RBEGamer/ArduinoRGBTable/PICTURES/2024-06-10 22.00.10.jpg

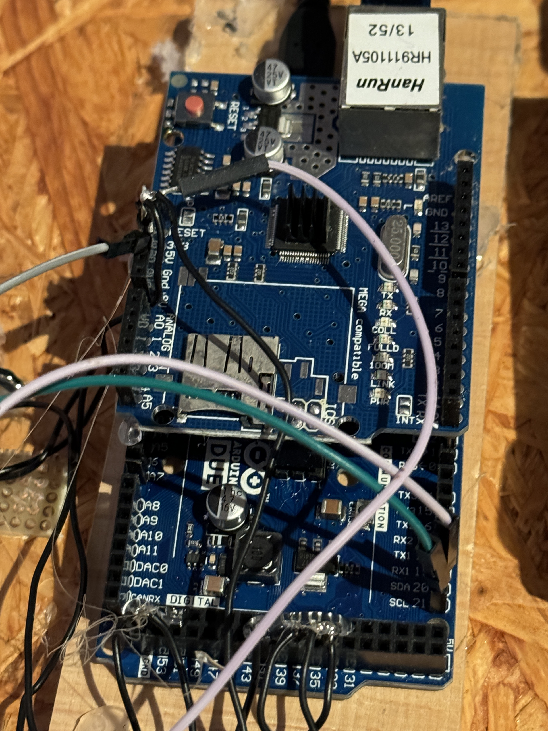
PICTURES/2024-06-10 22.00.10.jpg
