RBEGamer/ArduinoRGBTable/PICTURES/2024-06-10 22.13.32.jpg

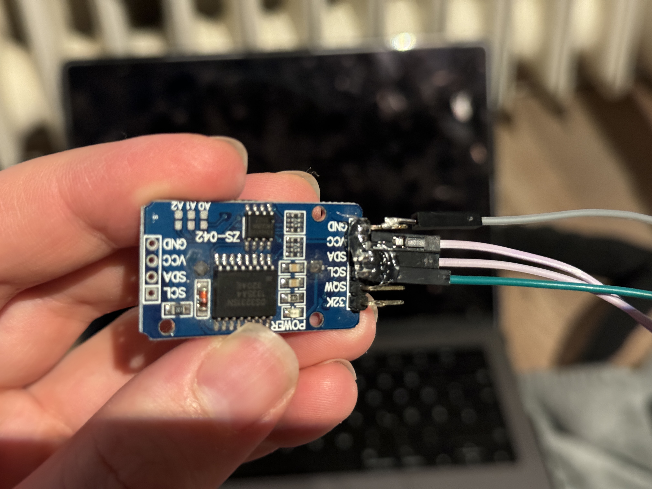
PICTURES/2024-06-10 22.13.32.jpg
