RBEGamer/ArduinoRGBTable/PICTURES/Photo-13-05-14-02-29-51-0.JPG

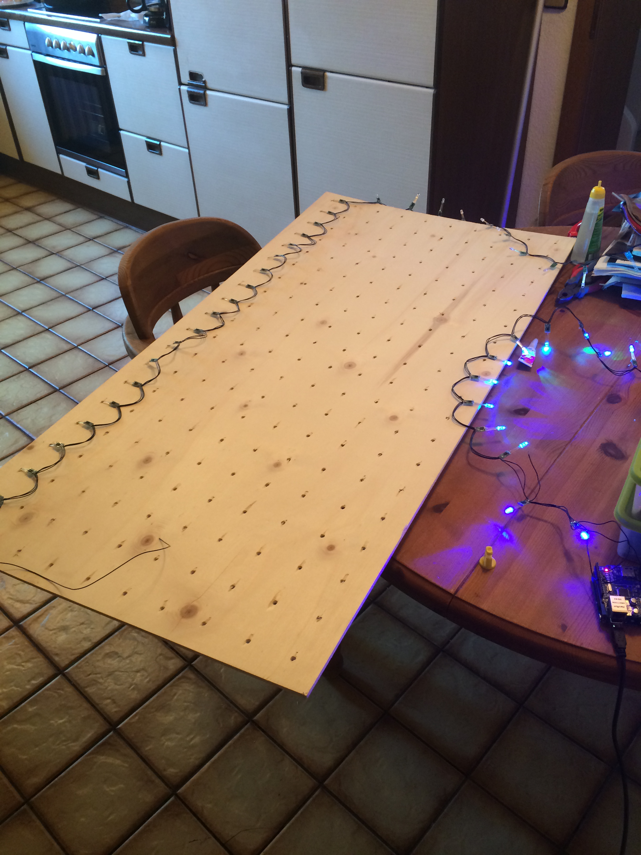
PICTURES/Photo-13-05-14-02-29-51-0.JPG
