RBEGamer/ArduinoRGBTable/PICTURES/Photo-13-05-14-02-29-52-5.JPG

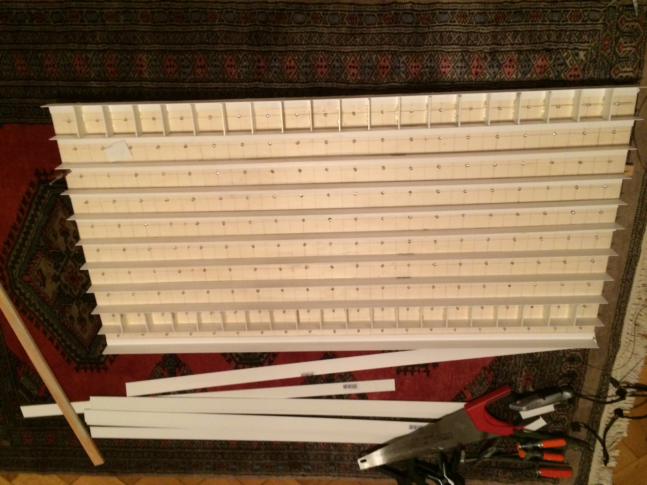
PICTURES/Photo-13-05-14-02-29-52-5.JPG
