RBEGamer/ArduinoRGBTable/PICTURES/Photo-13-05-14-02-29-52-9.JPG

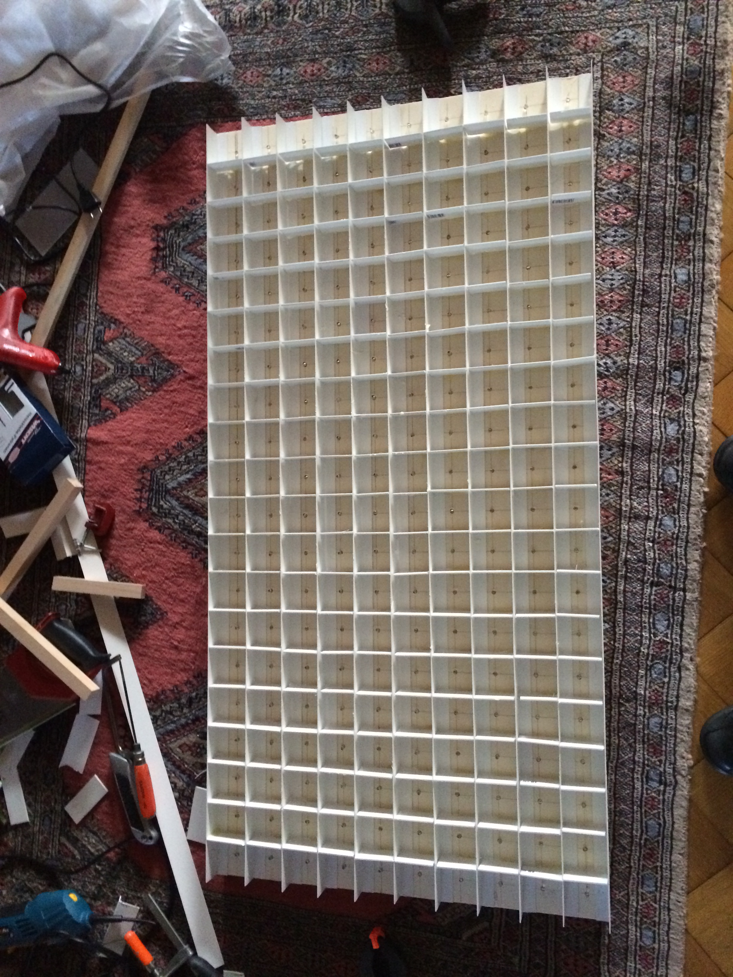
PICTURES/Photo-13-05-14-02-29-52-9.JPG
