RBEGamer/ArduinoRGBTable/PICTURES/Photo-13-05-14-02-29-53-15.JPG

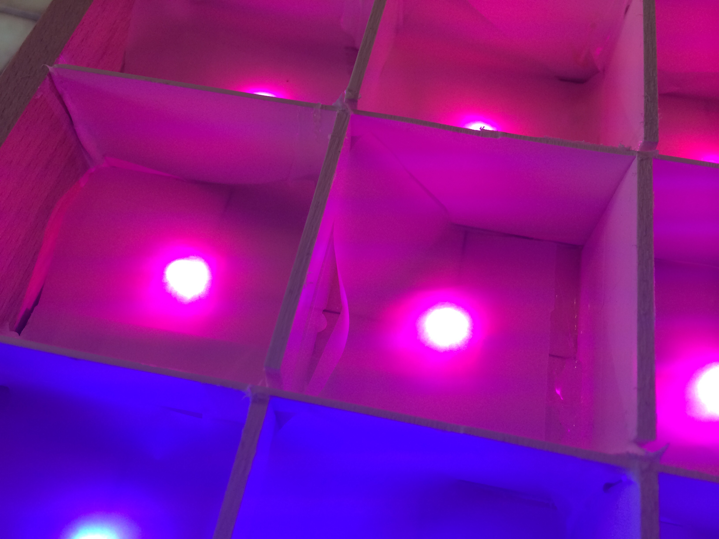
PICTURES/Photo-13-05-14-02-29-53-15.JPG
