RBEGamer/ArduinoRGBTable/PICTURES/Photo-13-05-14-02-29-53-21.JPG

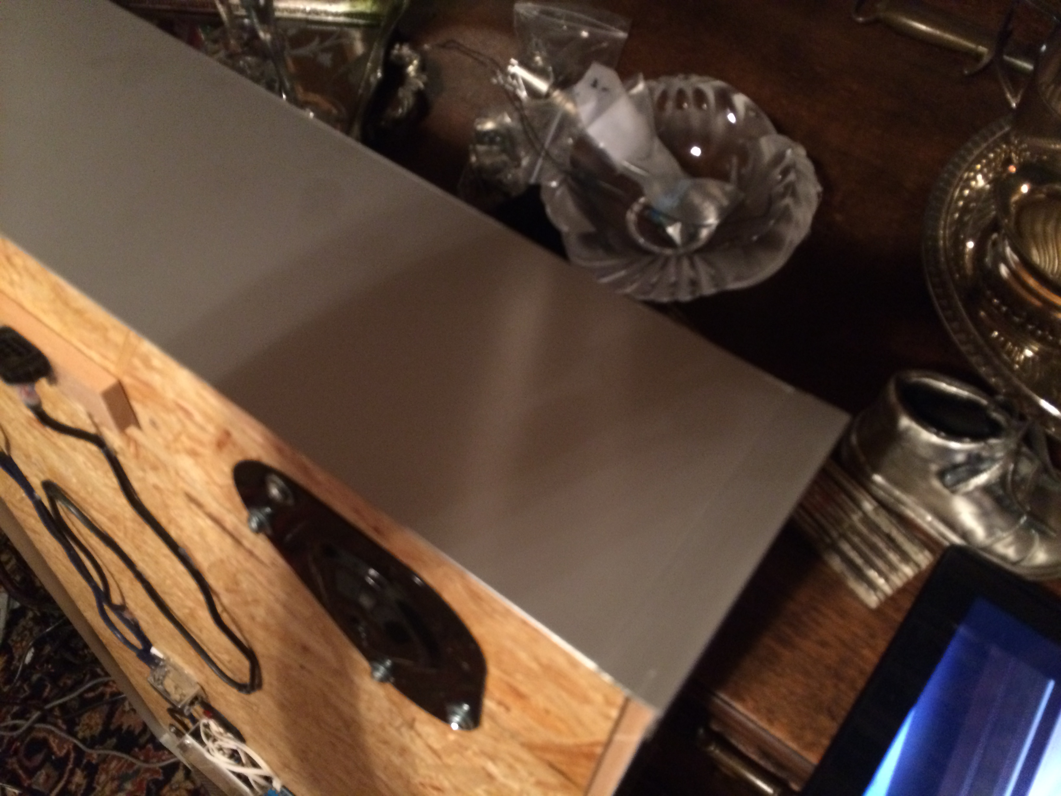
PICTURES/Photo-13-05-14-02-29-53-21.JPG
