RBEGamer/ArduinoRGBTable/PICTURES/Photo-13-05-14-02-29-53-23.JPG

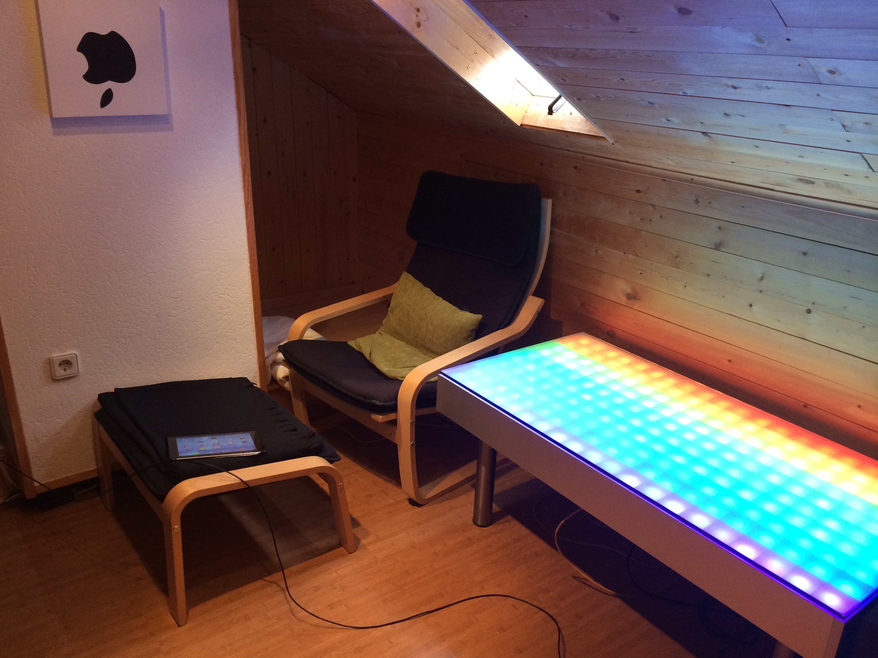
PICTURES/Photo-13-05-14-02-29-53-23.JPG
