RBEGamer/ArduinoRGBTable/PICTURES/Photo-13-05-14-02-29-54-25.JPG

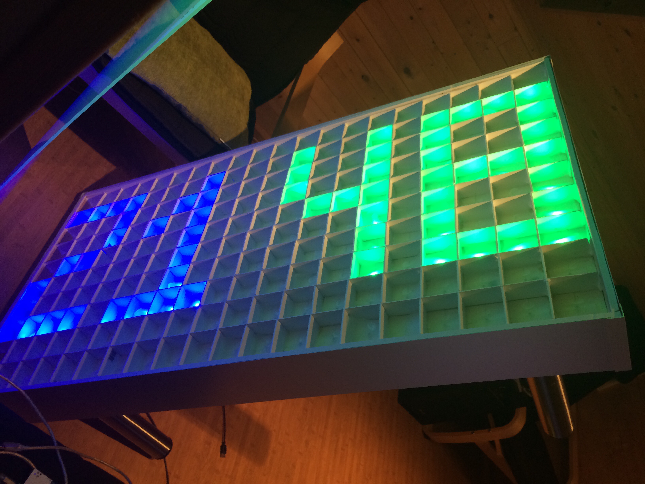
PICTURES/Photo-13-05-14-02-29-54-25.JPG
