RBEGamer/ArduinoRGBTable/src/table_due_beta35/table_due_beta35_Websitetitel.ino

#include <Adafruit_NeoPixel.h>
#include "SPI.h"
#include "Ethernet.h"
#include "WebServer.h"
#include "Wire.h"
#include <DueFlashStorage.h>
#include <TextFinder.h>

//PIN CONFIG
#define WS2812_PIN 33
#define WS2812_STANDBY_LED_PIN 31
const int relais = 35; //relais pin to enable the led power
const int fan = 37; //relais pin to enable the relais for the fan
const int pi_en = 39; // pin to send enabel for the T.I.S (RPI needed)
const int reset_jumper = 41; // pin for the standby switch

DueFlashStorage dueFlashStorage;
static uint8_t mac[6] = { 0x00, 0x00, 0x00, 0x00, 0x00, 0x23 };
Adafruit_NeoPixel standby_strip = Adafruit_NeoPixel(1, WS2812_STANDBY_LED_PIN, NEO_RGB + NEO_KHZ800);
Adafruit_NeoPixel strip = Adafruit_NeoPixel(200, WS2812_PIN, NEO_RGB + NEO_KHZ800);


const String versionsnummer = "Beta 1.5.5";
String webTitle = "RBE LED-Table";

int nullpunkt = 0; //0: oben links, 1: oben rechts, 2: unten links, 3: unten rechts
int Ausrichtung = 0; //0: Ausrichtung nach Reihe; 1: Ausrichtung nach Spalte
int invertNES = 0; //0 = nicht invertieren, 1 gleich invertieren
const int webui_port = 80;

//FÜR SERVER << "";
template<class T>
inline Print &operator <<(Print &obj, T arg)
{
  obj.print(arg);
  return obj;
}
#define PREFIX "" //WEBSERVER ROOT URL (http://ip/xxx
WebServer webserver(PREFIX, webui_port);
const unsigned int feldx = 20;
const unsigned int feldy = 10;

const int baud_rate = 115200;

int fillred = 0;            //integer for red darkness
int fillblue = 0;           //integer for blue darkness
int fillgreen = 0;          //integer for green darkness
int fan_state = 0;
int mode = 5; // MODE 5 = off
int rainbowspeed = 50;
int randomspeed = 10;
int randommode = 0; // 0-1
int rainbowmode = 0; // 0 oder 1
int randomefmode = 0;
int standby_strip_state = 0; //FÜR DIE STANDBYLED
int standby_strip_fade = 0;
int standby_strip_fade_richtung = 0; // 0 = plus, 1 = minus
IPAddress ip(192, 168, 178, 210);
IPAddress gateway(192, 168, 178, 1);
IPAddress subnet(255, 255, 255, 0);
const int use_ethernet = 1, wait_for_DHCP = 0;
int enable_dhcp = 1;
int api_enable = 1;
int standby_strip_en = 1;
const int webTitle_max_char = 40;
//CLOCK VARS---------------------------------------------------------------------------------------------------
#define DS1307_I2C_ADDRESS 0x68  // This is the I2C address
// Arduino version compatibility Pre-Compiler Directives
#if defined(ARDUINO) && ARDUINO >= 100   // Arduino v1.0 and newer
#define I2C_WRITE Wire.write
#define I2C_READ Wire.read
#else                                   // Arduino Prior to v1.0 
#define I2C_WRITE Wire.send
#define I2C_READ Wire.receive
#endif
long previousMillis = 0;        // will store last time Temp was updated
byte second, minute, hour, dayOfWeek, dayOfMonth, month, year;
byte test;
byte zero;
// Convert normal decimal numbers to binary coded decimal
byte decToBcd(byte val) {
  return ( (val / 10 * 16) + (val % 10) );
}
// Convert binary coded decimal to normal decimal numbers
byte bcdToDec(byte val) {
  return ( (val / 16 * 10) + (val % 16) );
}
int clockcolormode = 0;
int clock_h_color;
int clock_m_color;
int clock_fix_color_h = 0;
int clock_fix_color_m = 0;
int clock_bright = 255;
int h_z = 0;
int h_e = 0;
byte binwert_h_z;
byte binwert_h_e;
int m_z = 0;
int m_e = 0;
byte binwert_m_z;
byte binwert_m_e;
unsigned int localPort = 8888;      // local port to listen for UDP packets
IPAddress timeServer(132, 163, 4, 103);
const int NTP_PACKET_SIZE = 48; // NTP time stamp is in the first 48 bytes of the message
byte packetBuffer[ NTP_PACKET_SIZE]; //buffer to hold incoming and outgoing packets
EthernetUDP Udp;
int ntph = 0;
int ntpm = 0;
int ntps = 0;
unsigned int zeitverschiebung = 2; //zeit um 2 stunden nach vorne verschieben
int clock_color_counter = 0;
int clock_color_speed = 50;
int nth = 22;
int nthe = 7;
int nthen = 1;
int nthstate = 0;
int nthonmode = 1;
int nthoffmode = 6;
int number_template_0[4][7];
int number_template_1[4][7];
int number_template_2[4][7];
int number_template_3[4][7];
int number_template_4[4][7];
int number_template_5[4][7];
int number_template_6[4][7];
int number_template_7[4][7];
int number_template_8[4][7];
int number_template_9[4][7];
int number_template_nothing[4][7];

int time1[4][7]; // 0 oder 1 (0 = nicht gesetzt)
int time2[4][7];
int time3[4][7];
int time4[4][7];
int time1_anchor[2] = {16, 2}; // HZ
int time2_anchor[2] = {11, 2}; //HE
int time3_anchor[2] = {5, 2}; // MZ
int time4_anchor[2] = {0, 2}; // ME
int template_buffer_array[4][7];
int tmp_hz, tmp_he, tmp_mz, tmp_me;
int x = 0, y = 0;
int _value;
//CLOCK VARS ENDE

//-----------------------------------------------------für bootscreeen + animation-------------------------------------------------------------------------------
int table_os_enable = 1;
//---------------------------------------------------------------------------------------------------------------------------------------------------------------------------------

//LAUFSCHRIFT VARS  ----------------------------------------------------------------------------------
const int st_prev_begin = 21; //versatz zum ersten buchstaben damit pixelfehler am anfang nicht auffahlen
const int st_after_end = feldx;//muss einmal die feldbreite sein damit auch die ersten buchstaben eingeflogen kommen und nicht schon am anfang da stehen
int st_text_pos = 0;
const int st_maxchar = 255;
char st_chars[st_maxchar] = {'h', 'e', 'l', 'l', 'o'};
int st_char_count = 5;
int st_speed = 70;
const int st_spacing = 2;
int st_laufschrift_complete_arr[((5 + st_spacing)*st_maxchar) + st_after_end + st_prev_begin][7];
int st_anchor[2] = {0, 0};
int st_char_count_saved = 0;
int st_chars_saved[st_maxchar];
int st_fix_color = 0;
int st_rain_speed = 5;
int st_color_mode = 0;
int st_bright = 255;
int st_color = 0;
int st_color_counter = 0;

//TIS VARS ---+ die st_ vars-------------------------------------------------------------------------------
int rss_enable = 1;
int rss_state = 0;
int rss_prev_mode = 3;
const int rss_mode = 9;
char rss_chars[st_maxchar];
int rss_text_count = 0;
int rss_max_loops = 3;
int rss_current_loops = 0;
int rss_can_break_during_game = 1;
int rss_recive_count = 0;
String rss_revive_cmd = "";

int char_template[5][7];
int char_template_a[5][7];
int char_template_b[5][7];
int char_template_c[5][7];
int char_template_d[5][7];
int char_template_e[5][7];
int char_template_f[5][7];
int char_template_g[5][7];
int char_template_h[5][7];
int char_template_i[5][7];
int char_template_j[5][7];
int char_template_k[5][7];
int char_template_l[5][7];
int char_template_m[5][7];
int char_template_n[5][7];
int char_template_o[5][7];
int char_template_p[5][7];
int char_template_q[5][7];
int char_template_r[5][7];
int char_template_s[5][7];
int char_template_t[5][7];
int char_template_u[5][7];
int char_template_v[5][7];
int char_template_w[5][7];
int char_template_x[5][7];
int char_template_y[5][7];
int char_template_z[5][7];
int char_template_sz[5][7];
int char_template_1[5][7];
int char_template_2[5][7];
int char_template_3[5][7];
int char_template_4[5][7];
int char_template_5[5][7];
int char_template_6[5][7];
int char_template_7[5][7];
int char_template_8[5][7];
int char_template_9[5][7];
int char_template_0[5][7];
int char_template_nothing[5][7];
int char_template_sharp[5][7];
int char_template_dot[5][7];
int char_template_comma[5][7];
int char_template_bracketopen[5][7];
int char_template_bracketclose[5][7];
int char_template_equal[5][7];
int char_template_plus[5][7];
int char_template_minus[5][7];
int char_template_bang[5][7];
int char_template_doubledot[5][7];
int char_template_underline[5][7];
int char_template_quest[5][7];
int char_template_percent[5][7];
int char_template_high[5][7];
int char_template_simikolon[5][7];
int char_template_smaller[5][7];
int char_template_bigger[5][7];
int char_template_hline[5][7];
int char_template_star[5][7];
int char_template_at[5][7];
//ENDE LAUFSCHRIFT VARS ----------------------------------------------------------------------------------

//PAINT VARS--------------------------------
int paint_boot_strip[70];
int paint_boot_wheelpos = 0;
int paint_wheel_pos = 0;
int paint_pointer[2] = {feldx / 2, feldy / 2};
int paint_ponter_color[3] = {255, 255, 255};
int paint_grid[feldx][feldy][3];
int paint_color_display_mode = 0;
int paint_background[3] = {0, 0, 0};

//SQUARE VARS---------------------------------
const int square_number_field_offset[2] = {5, 0};
int square_number_field[5][5][2]; // 0 = wert // 1 = moved
int square_new_number_pos[2];
int square_start_numbers[2] = {2, 4};
int square_new_number = 0;
int square_cycle_value = 0;
int square_active_fields = 0;
int square_allow_reset = 1;
int square_animation_speed = 10;
byte square_p1_controller_data_tmp = 0;
unsigned int square_boot_strip[48];
int square_boot_wheelpos = 0;

//SENSO VARS-------------------------
unsigned int senso_strip[44];
unsigned int senso_cross_strip[5];
unsigned int senso_cross_up;
unsigned int senso_cross_down;
unsigned int senso_cross_left;
unsigned int senso_cross_right;
unsigned int senso_select_strip[2];
unsigned int senso_start_strip[2];
unsigned int senso_b_strip[4];
unsigned int senso_a_strip[4];
int senso_show_buttons = 1;
int senso_include_startselect = 0;
const int senso_max_length = 100;
byte senso_p1_controller_data_tmp = 0;
int senso_order[senso_max_length] = {0};
int senso_length = 1;
int senso_p1_pos = 0;
int senso_player_wrong = 0; //0: beide richtig, 1: p1 falsch, 2: p2 falsch, 3:beide falsch
int senso_wheelpos = 1;
int senso_button_color_r = 255, senso_button_color_g = 255, senso_button_color_b = 0;
int senso_button_order_r = 0, senso_button_order_g = 0, senso_button_order_b = 255;
int senso_last_button_red = 0;
int senso_show_delay = 500;

//PONG VARS ----------------------------------------------------------------------------------
unsigned int pong_boot_strip[66];
int pong_boot_wheelpos = 0;
int ballx = feldx / 2;
int bally = feldy / 2;
int balldir = 4; //random
int player1score = 0;
int player2score = 0;
int paddle1x = 0;
int paddle2x = feldx - 1;
int paddle1y = 0;
int paddle2y = 0;
int paddle1size = 3;
int paddle2size = 3;
int tmp_paddle1y = 0;
int tmp_paddle2y = 0;
const int action_timer = 3; //WIE VIELE KONTROLLERABFRAGEN PRO BALLBEWEGUNG
int unsigned pong_game_speed = 50; //ANFANGSSPEED
const unsigned int min_game_speed = 10; //MINIMUM SPEED
int tmp_speed = 0; //HIER IST IMME DER AKTUELLE SPPED DRINNE
const int score_delay = 3000;
int player1score_tmp = 0; //FÜR DIE SPEED BERECHNUNG
int player2score_tmp = 0;
int ball_r = 0, ball_g = 0, ball_b = 255;
int p1_r = 0, p1_g = 255, p1_b = 0;
int p2_r = 255, p2_g = 0, p2_b = 0;
int p1_latch = A1; // set the latch pin
int p1_clock = A0; // set the clock pin
int p1_datin = A2;// set the data in pin
int p2_latch = A4;// set the latch pin
int p2_clock = A3; // set the clock pin
int p2_datin = A5;// set the data in pin
byte p1_controller_data = 0;
byte p2_controller_data = 0;
int counter = 0;//WIE VIELE KONTROLLERABFRAGEN haben bereits stattgefunden PRO BALLBEWEGUNG
const int max_score = feldy; //MAXIMALE MPUNKTE MUSS KLEINER ALS Y PIXELANZAHL
int last_looser = 0; //WER HAT ZULETZT VERLOREN FÜR DIE FARBEN BEIM SCORESCREEN
int color_state = 0; // 0-> nach rot 1-> nach grün 2-> nach blau
int tmp_green = 0;
int tmp_red = 0;
int tmp_blue = 0;
int fade_speed = 5;
int pongmode = 1;
int chenp1 = 0;
int chenp2 = 0;
int pongenreset = 0;
// ENDE PONG VARS -------------------------------

void set_arrays() { //muss immer ausgeführt werden wenn der nullpunkt geändert wurde
  //table os bootscreen



  //----------------------------------
  //square bootscreen
  square_boot_strip = { get_led_number(0, 7), get_led_number(0, 4), get_led_number(1, 7), get_led_number(1, 5), get_led_number(1, 3), get_led_number(2, 6), get_led_number(2, 3), get_led_number(4, 6), get_led_number(4, 5), get_led_number(4, 4), get_led_number(5, 7), get_led_number(5, 3), get_led_number(6, 7), get_led_number(6, 6), get_led_number(6, 3), get_led_number(7, 6), get_led_number(7, 5), get_led_number(7, 4), get_led_number(9, 7), get_led_number(9, 6), get_led_number(9, 5), get_led_number(9, 4), get_led_number(10, 5), get_led_number(10, 3), get_led_number(11, 5), get_led_number(11, 3), get_led_number(12, 7), get_led_number(12, 6), get_led_number(12, 5), get_led_number(12, 4), get_led_number(14, 7), get_led_number(14, 6), get_led_number(14, 5), get_led_number(14, 4), get_led_number(14, 3), get_led_number(15, 5), get_led_number(15, 3), get_led_number(16, 7), get_led_number(16, 6), get_led_number(16, 4), get_led_number(18, 7), get_led_number(18, 6), get_led_number(18, 5), get_led_number(18, 4), get_led_number(18, 3), get_led_number(19, 7), get_led_number(19, 5), get_led_number(19, 3)};
  //--------------------------------
  //senso
  senso_strip = { get_led_number(0, 4), get_led_number(0, 7), get_led_number(1, 3), get_led_number(1, 5), get_led_number(1, 7), get_led_number(2, 3), get_led_number(2, 6), get_led_number(4, 3), get_led_number(4, 4), get_led_number(4, 5), get_led_number(4, 6), get_led_number(4, 7), get_led_number(5, 3), get_led_number(5, 5), get_led_number(5, 7), get_led_number(7, 3), get_led_number(7, 4), get_led_number(7, 5), get_led_number(7, 6), get_led_number(7, 7), get_led_number(8, 4), get_led_number(9, 5), get_led_number(10, 3), get_led_number(10, 4), get_led_number(10, 5), get_led_number(10, 6), get_led_number(10, 7), get_led_number(12, 4), get_led_number(12, 7), get_led_number(13, 3), get_led_number(13, 5), get_led_number(13, 7), get_led_number(14, 3), get_led_number(14, 6), get_led_number(16, 4), get_led_number(16, 5), get_led_number(16, 6), get_led_number(17, 3), get_led_number(17, 7), get_led_number(18, 3), get_led_number(18, 7), get_led_number(19, 4), get_led_number(19, 5), get_led_number(19, 6)};
  senso_cross_strip = { get_led_number(1, 5), get_led_number(2, 4), get_led_number(2, 5), get_led_number(2, 6), get_led_number(3, 5)};
  senso_cross_up = get_led_number(2, 4);
  senso_cross_down = get_led_number(2, 6);
  senso_cross_left = get_led_number(1, 5);
  senso_cross_right = get_led_number(3, 5);
  senso_select_strip = {get_led_number(6, 5), get_led_number(7, 5)};
  senso_start_strip = {get_led_number(10, 5), get_led_number(11, 5) };
  senso_b_strip = {get_led_number(14, 4), get_led_number(14, 5), get_led_number(15, 4), get_led_number(15, 5)};
  senso_a_strip = {get_led_number(17, 4), get_led_number(17, 5), get_led_number(18, 4), get_led_number(18, 5)};
  //------------------------------------------
  //pong
  pong_boot_strip = {get_led_number(0, 1), get_led_number(0, 2), get_led_number(0, 3), get_led_number(0, 4), get_led_number(0, 5), get_led_number(0, 6), get_led_number(0, 7), get_led_number(0, 8), get_led_number(1, 1), get_led_number(1, 4), get_led_number(2, 1), get_led_number(2, 4), get_led_number(3, 2), get_led_number(3, 3), get_led_number(5, 2), get_led_number(5, 3), get_led_number(5, 4), get_led_number(5, 5), get_led_number(5, 6), get_led_number(5, 7), get_led_number(6, 1), get_led_number(6, 8), get_led_number(7, 1), get_led_number(7, 8), get_led_number(8, 2), get_led_number(8, 3), get_led_number(8, 4), get_led_number(8, 5), get_led_number(8, 6), get_led_number(8, 7), get_led_number(10, 1), get_led_number(10, 2), get_led_number(10, 3), get_led_number(10, 4), get_led_number(10, 5), get_led_number(10, 6), get_led_number(10, 7), get_led_number(10, 8), get_led_number(11, 1), get_led_number(11, 2), get_led_number(12, 3), get_led_number(12, 4), get_led_number(13, 5), get_led_number(13, 6), get_led_number(14, 1), get_led_number(14, 2), get_led_number(14, 3), get_led_number(14, 4), get_led_number(14, 5), get_led_number(14, 6), get_led_number(14, 7), get_led_number(14, 8), get_led_number(16, 2), get_led_number(16, 3), get_led_number(16, 4), get_led_number(16, 5), get_led_number(16, 6), get_led_number(16, 7), get_led_number(17, 1), get_led_number(17, 8), get_led_number(18, 1), get_led_number(18, 5), get_led_number(18, 8), get_led_number(19, 2), get_led_number(19, 6), get_led_number(19, 7) };
  //---------------------------------------------
  //paint
  paint_boot_strip = {get_led_number(0, 1), get_led_number(0, 2), get_led_number(0, 3), get_led_number(0, 4), get_led_number(0, 5), get_led_number(0, 6), get_led_number(0, 7), get_led_number(0, 8), get_led_number(1, 1), get_led_number(1, 4), get_led_number(2, 1), get_led_number(2, 4), get_led_number(3, 2), get_led_number(3, 3),  get_led_number(5, 2), get_led_number(5, 3), get_led_number(5, 4), get_led_number(5, 5), get_led_number(5, 6), get_led_number(5, 7), get_led_number(5, 8), get_led_number(6, 1), get_led_number(6, 4), get_led_number(7, 2), get_led_number(7, 3), get_led_number(7, 4), get_led_number(7, 5), get_led_number(7, 6), get_led_number(7, 7), get_led_number(7, 8), get_led_number(9, 1), get_led_number(9, 2), get_led_number(9, 3), get_led_number(9, 4), get_led_number(9, 5), get_led_number(9, 6), get_led_number(9, 7), get_led_number(9, 8), get_led_number(11, 1), get_led_number(11, 2), get_led_number(11, 3), get_led_number(11, 4), get_led_number(11, 5), get_led_number(11, 6), get_led_number(11, 7), get_led_number(11, 8), get_led_number(12, 1), get_led_number(12, 2), get_led_number(13, 3), get_led_number(13, 4), get_led_number(14, 5), get_led_number(14, 6), get_led_number(15, 1), get_led_number(15, 2), get_led_number(15, 3), get_led_number(15, 4), get_led_number(15, 5), get_led_number(15, 6), get_led_number(15, 7), get_led_number(15, 8), get_led_number(17, 1), get_led_number(18, 1), get_led_number(18, 2), get_led_number(18, 3), get_led_number(18, 4), get_led_number(18, 5), get_led_number(18, 6), get_led_number(18, 7), get_led_number(18, 8), get_led_number(19, 1)};
  //-----------------------------------------------
}

void st_text_to_arr() {
  for (int i = 0; i < ((5 + st_spacing)*st_maxchar) + st_after_end + st_prev_begin; i++) {
    for (int j = 0; j < 7; j++) {
      st_laufschrift_complete_arr[i][j] = 0;
    }
  }
  for (int k = 0; k < st_char_count; k++) {
    if (st_chars[k] == 'a' || st_chars[k] == 'A') {
      for (int i = 0; i < 5; i++) {
        for (int j = 0; j < 7; j++) {
          char_template[i][j] = char_template_a[i][j];
        }
      }
    }
    if (st_chars[k] == 'b' || st_chars[k] == 'B') {
      for (int i = 0; i < 5; i++) {
        for (int j = 0; j < 7; j++) {
          char_template[i][j] = char_template_b[i][j];
        }
      }
    }
    if (st_chars[k] == 'c' || st_chars[k] == 'C') {
      for (int i = 0; i < 5; i++) {
        for (int j = 0; j < 7; j++) {
          char_template[i][j] = char_template_c[i][j];
        }
      }
    }
    if (st_chars[k] == 'd' || st_chars[k] == 'D') {
      for (int i = 0; i < 5; i++) {
        for (int j = 0; j < 7; j++) {
          char_template[i][j] = char_template_d[i][j];
        }
      }
    }
    if (st_chars[k] == 'e' || st_chars[k] == 'E') {
      for (int i = 0; i < 5; i++) {
        for (int j = 0; j < 7; j++) {
          char_template[i][j] = char_template_e[i][j];
        }
      }
    }
    if (st_chars[k] == 'f' || st_chars[k] == 'F') {
      for (int i = 0; i < 5; i++) {
        for (int j = 0; j < 7; j++) {
          char_template[i][j] = char_template_f[i][j];
        }
      }
    }
    if (st_chars[k] == 'g' || st_chars[k] == 'G') {
      for (int i = 0; i < 5; i++) {
        for (int j = 0; j < 7; j++) {
          char_template[i][j] = char_template_g[i][j];
        }
      }
    }
    if (st_chars[k] == 'h' || st_chars[k] == 'H') {
      for (int i = 0; i < 5; i++) {
        for (int j = 0; j < 7; j++) {
          char_template[i][j] = char_template_h[i][j];
        }
      }
    }
    if (st_chars[k] == 'i' || st_chars[k] == 'I') {
      for (int i = 0; i < 5; i++) {
        for (int j = 0; j < 7; j++) {
          char_template[i][j] = char_template_i[i][j];
        }
      }
    }
    if (st_chars[k] == 'j' || st_chars[k] == 'J') {
      for (int i = 0; i < 5; i++) {
        for (int j = 0; j < 7; j++) {
          char_template[i][j] = char_template_j[i][j];
        }
      }
    }
    if (st_chars[k] == 'k' || st_chars[k] == 'K') {
      for (int i = 0; i < 5; i++) {
        for (int j = 0; j < 7; j++) {
          char_template[i][j] = char_template_k[i][j];
        }
      }
    }
    if (st_chars[k] == 'l' || st_chars[k] == 'L') {
      for (int i = 0; i < 5; i++) {
        for (int j = 0; j < 7; j++) {
          char_template[i][j] = char_template_l[i][j];
        }
      }
    }
    if (st_chars[k] == 'm' || st_chars[k] == 'M') {
      for (int i = 0; i < 5; i++) {
        for (int j = 0; j < 7; j++) {
          char_template[i][j] = char_template_m[i][j];
        }
      }
    }
    if (st_chars[k] == 'n' || st_chars[k] == 'N') {
      for (int i = 0; i < 5; i++) {
        for (int j = 0; j < 7; j++) {
          char_template[i][j] = char_template_n[i][j];
        }
      }
    }
    if (st_chars[k] == 'o' || st_chars[k] == 'O') {
      for (int i = 0; i < 5; i++) {
        for (int j = 0; j < 7; j++) {
          char_template[i][j] = char_template_o[i][j];
        }
      }
    }
    if (st_chars[k] == 'p' || st_chars[k] == 'P') {
      for (int i = 0; i < 5; i++) {
        for (int j = 0; j < 7; j++) {
          char_template[i][j] = char_template_p[i][j];
        }
      }
    }
    if (st_chars[k] == 'q' || st_chars[k] == 'Q') {
      for (int i = 0; i < 5; i++) {
        for (int j = 0; j < 7; j++) {
          char_template[i][j] = char_template_q[i][j];
        }
      }
    }
    if (st_chars[k] == 'r' || st_chars[k] == 'R') {
      for (int i = 0; i < 5; i++) {
        for (int j = 0; j < 7; j++) {
          char_template[i][j] = char_template_r[i][j];
        }
      }
    }
    if (st_chars[k] == 's' || st_chars[k] == 'S') {
      for (int i = 0; i < 5; i++) {
        for (int j = 0; j < 7; j++) {
          char_template[i][j] = char_template_s[i][j];
        }
      }
    }
    if (st_chars[k] == 't' || st_chars[k] == 'T') {
      for (int i = 0; i < 5; i++) {
        for (int j = 0; j < 7; j++) {
          char_template[i][j] = char_template_t[i][j];
        }
      }
    }
    if (st_chars[k] == 'u' || st_chars[k] == 'U') {
      for (int i = 0; i < 5; i++) {
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
          char_template[i][j] = char_template_nothing[i][j];
        }
      }
    }
    for (int i = 0; i < 5; i++) {
      for (int j = 0; j < 7; j++) {
        st_laufschrift_complete_arr[(k * st_spacing * 3) + st_prev_begin + i][j] = char_template[i][j];
      }
    }
  }
}

void rss_convert_text() {
  st_save_text();
  clear_screen();
  strip.show();
  for (int i = 0; i < st_maxchar; i++) {
    st_chars[i] = 0;
    st_chars[i] = rss_chars[i];
  }
  st_char_count = rss_text_count;
  rss_current_loops = 0;
  rss_state = 1;
}

void rss_process() {
  if (rss_enable == 1) {
    if (rss_state == 1) {
      if (mode != rss_mode) {
        if (rss_can_break_during_game == 1) {
          mode = rss_mode;
        } else {
          if (mode  == 4) {} else {
            mode = rss_mode;
          }
          if (mode  == 10) {} else {
            mode = rss_mode;
          }
          if (mode  == 11) {} else {
            mode = rss_mode;
          }
          if (mode  == 12) {} else {
            mode = rss_mode;
          }
        }
      }
      if (rss_current_loops > rss_max_loops) {
        rss_state = 0;
        rss_current_loops = 0;
        for (int i = 0; i < st_maxchar; i++) {
          rss_chars[i] = 0;
        }
        st_restore_text();
        clear_screen();
        strip.show();
      }
    }
  }
}

void rss_recive_serial() {
  if (Serial1.available()) {
    char c = Serial1.read();
    if (c == '\n') {
      rss_recive_count = 0;
      rss_revive_cmd = "";
      rss_revive_cmd.toCharArray(rss_chars, st_maxchar);
      rss_convert_text();
      rss_state = 1;
    } else {
      rss_revive_cmd += c;
      rss_recive_count++;
    }
  }
}

void st_save_text() {
  st_char_count_saved = st_char_count;
  for (int i = 0; i < st_maxchar; i++) {
    st_chars_saved[i] = 0;
    st_chars_saved[i] = st_chars[i];
  }
}

void st_restore_text() {
  for (int i = 0; i < st_maxchar; i++) {
    st_chars[i] = 0;
    st_chars[i] = st_chars_saved[i];
  }
  st_char_count = st_char_count_saved;
}

void st_play() {
  if (st_text_pos >= ((5 + st_spacing)*st_char_count) + st_after_end + st_prev_begin) {
    st_text_pos = 0;
    rss_current_loops++;
  } else {
    st_text_pos++;
  }
  if (st_color_counter >= 256) {
    st_color_counter = 0;
  } else {
    st_color_counter += st_rain_speed;
  }
  if (st_color_mode == 0) {
    st_color =  Wheel(st_color_counter);
  } else if (st_color_mode == 1) {
    if (st_fix_color == 0) {
      st_color =  strip.Color(st_bright, 0, 0);
    } else  if (st_fix_color == 1) {
      st_color =  strip.Color(0, st_bright, 0);
    } else  if (st_fix_color == 2) {
      st_color =  strip.Color(0, 0, st_bright);
    } else  if (st_fix_color == 3) {
      st_color =  strip.Color(0, st_bright, st_bright);
    } else  if (st_fix_color == 4) {
      st_color =  strip.Color(st_bright, 0, st_bright);
    } else  if (st_fix_color == 5) {
      st_color =  strip.Color(st_bright, st_bright, 0);
    } else  if (st_fix_color == 6) {
      st_color =  strip.Color(st_bright, st_bright, st_bright);
    } else {
      st_color =  strip.Color(0, 0, 255);
    }
  } else if (st_color_mode == 2) {
  } else {
    st_color =  strip.Color(0, 0, 255);
  }
  for (int i = 0; i < 20; i++) {
    for (int j = 0; j < 7; j++) {
      if (st_color_mode == 2) {
        st_color =  Wheel(random(0, 257));
      }
      if (st_laufschrift_complete_arr[st_prev_begin + st_text_pos + i - st_after_end][j] == 1) {
        strip.setPixelColor(get_led_number(i + st_anchor[0], j + st_anchor[1] + 1),  st_color);
      } else {
        strip.setPixelColor(get_led_number(i + st_anchor[0], j + st_anchor[1] + 1),  strip.Color(0, 0, 0));
      }
    }
  }
  delay(st_speed);
}//ENDE VOID

P(phead1) =
  "<!DOCTYPE html><html><head>"
  "<title>";
  
P(phead2) =
  "</title>"
  "<meta http-equiv='content-type' content='text/html; charset=utf-8'>"
  "<meta charset='utf-8'>"
  "<link href='http://ajax.googleapis.com/ajax/libs/jqueryui/1.8.16/themes/base/jquery-ui.css' rel=stylesheet />"
  "<script src='http://ajax.googleapis.com/ajax/libs/jquery/1.6.4/jquery.min.js'></script>"
  "<script src='http://ajax.googleapis.com/ajax/libs/jqueryui/1.8.16/jquery-ui.min.js'></script>"
  "<style> body {  } #red, #green, #blue { margin: 10px; } #red { background: #f00; } #green { background: #0f0; } #blue { background: #00f; } </style>"
  "<script>"
  "function changeRGB(event, ui) { jQuery.ajaxSetup({timeout: 110}); /*not to DDoS the Arduino, you might have to change this to some threshold value that fits your setup*/ var id = $(this).attr('id'); if (id == 'red') $.post('/rgb', { red: ui.value } ); if (id == 'green') $.post('/rgb', { green: ui.value } ); if (id == 'blue') $.post('/rgb', { blue: ui.value } ); } "
  "$(document).ready(function(){ $('#red, #green, #blue').slider({min: 0, max:255, change:changeRGB, slide:changeRGB}); });"
  "</script>"
  "<style>"

  "html, body {"
  "	background: #F2F2F2;"
  "	width: 100%;"
  "	height: 100%;"
  "	margin: 0px;"
  "	padding: 0px;"
  "	font-family: 'Verdana';"
  "	font-size: 16px;"
  "	color: #404040;"
  "	}"
  "img {"
  "	border: 0px;"
  "}"
  "span.title {"
  "	display: block;"
  "	color: #000000;"
  "	font-size: 30px;"
  "}"
  "span.subtitle {"
  "	display: block;"
  "	color: #000000;"
  "	font-size: 20px;"
  "}"
  ".sidebar {"
  "	background: #FFFFFF;"
  "	width: 250px;"
  "	min-height: 100%;"
  "	height: 100%;"
  "	height: auto;"
  "	position: fixed;"
  "	top: 0px;"
  "	left: 0px;"
  "	border-right: 1px solid #D8D8D8;"
  "}"
  ".logo {"
  "	padding: 25px;"
  "	text-align: center;"
  "	border-bottom: 1px solid #D8D8D8;"
  "}"
  ".menu {"
  "	padding: 25px 0px 25px 0px;"
  "	border-bottom: 1px solid #D8D8D8;"
  "}"
  ".menu a {"
  "	padding: 15px 25px 15px 25px;"
  "	display: block;"
  "	color: #000000;"
  "	text-decoration: none;"
  "	transition: all 0.25s;"
  "}"
  ".menu a:hover {"
  "	background: #0088CC;"
  "	color: #FFFFFF;"
  "}"
  ".right {"
  "	margin-left: 250px;"
  "	padding: 50px;"
  "}"
  ".content {"
  "	background: #FFFFFF;"
  "	padding: 25px;"
  "	border-radius: 5px;"
  "	border: 1px solid #D8D8D8;"
  "}"
  "</style>";
  

P(pstart) = "</head>"
            "<body style='font-size:62.5%;'>"
            "<div class='sidebar'>"
            "<div class='logo'>"
            "<span class='title'>LED TABLE</span>"
            "<span class='subtitle'>- Backend -</span>"
            "</div>"
            "<div class='menu'>"
            "<a href='index.html'>Dashboard</a>"
            "<a href='/rgb'>MODE</a>"
            "<a href='settings.html'>SETTINGS</a>"
            "<a href='api.html'>API (BETA)</a>"
            "<a href='tis.html'>T.I.S</a>"
            "</div>"
            "</div>"
            "<div class='right'>"
            "<div class='content'>";

P(pend) = "</div>"
          "</div>"
          "</body>"
          "</html>";

P(api_table) = "<style type='text/css'>"
               ".tg  {border-collapse:collapse;border-spacing:0;margin:0px auto;}"
               ".tg td{font-family:Arial, sans-serif;font-size:14px;padding:10px 5px;border-style:solid;border-width:1px;overflow:hidden;word-break:normal;}"
               ".tg th{font-family:Arial, sans-serif;font-size:14px;font-weight:normal;padding:10px 5px;border-style:solid;border-width:1px;overflow:hidden;word-break:normal;}"
               ".tg .tg-s6z2{text-align:center}"
               "</style>"
               "<table class='tg' style='undefined;table-layout: fixed; width: 520px'>"
               "<colgroup>"
               "<col style='width: 160px'>"
               "<col style='width: 100px'>"
               "<col style='width: 100px'>"
               "<col style='width: 160px'>"
               "</colgroup>"
               "  <tr>"
               "    <th class='tg-031e'>VARIABLE</th>"
               "    <th class='tg-031e'>GET</th>"
               "    <th class='tg-031e'>SET</th>"
               "    <th class='tg-031e'>DESCRIPTION</th>"
               "  </tr>"
               "  <tr>"
               "    <td class='tg-031e'>baud_rate</td>"
               "    <td class='tg-031e'>X</td>"
               "    <td class='tg-031e'></td>"
               "    <th class='tg-031e'>Serial (0-3) Baud Rate</th>"
               "  </tr>"
               "  <tr>"
               "    <td class='tg-031e'>fan_state</td>"
               "    <td class='tg-031e'>X</td>"
               "    <td class='tg-031e'>X</td>"
               "    <th class='tg-031e'>Fan-State</th>"
               "  </tr>"
               "  <tr>"
               "    <td class='tg-031e'>mode</td>"
               "    <td class='tg-031e'>X</td>"
               "    <td class='tg-031e'>X</td>"
               "    <th class='tg-031e'>CURRENT lED-MODE</th>"
               "  </tr>"
               "  <tr>"
               "    <td class='tg-031e'>rainbowspeed</td>"
               "    <td class='tg-031e'>X</td>"
               "    <td class='tg-031e'>X</td>"
               "    <th class='tg-031e'>RAINBOW CYCLE SPEED</th>"
               "  </tr>"
               "  <tr>"
               "    <td class='tg-031e'>randomspeed</td>"
               "    <td class='tg-031e'>X</td>"
               "    <td class='tg-031e'>X</td>"
               "    <th class='tg-031e'>RANDOMMODE SPEED</th>"
               "  </tr>"
               "  <tr>"
               "    <td class='tg-031e'>randomefmode</td>"
               "    <td class='tg-031e'>X</td>"
               "    <td class='tg-031e'>X</td>"
               "    <th class='tg-031e'>RANDOMMODE TYPE</th>"
               "  </tr>"
               "  <tr>"
               "    <td class='tg-031e'>enable_dhcp</td>"
               "    <td class='tg-031e'>X</td>"
               "    <td class='tg-031e'></td>"
               "    <th class='tg-031e'>DHCP STATE</th>"
               "  </tr>"
               "  <tr>"
               "    <td class='tg-031e'>wait_for_DHCP</td>"
               "    <td class='tg-031e'>X</td>"
               "    <td class='tg-031e'></td>"
               "    <th class='tg-031e'>STOP IF NO DHCP-SERVER IS AVARIABLE</th>"
               "  </tr>"
               "  <tr>"
               "    <td class='tg-031e'>zeitverschiebung</td>"
               "    <td class='tg-031e'>X</td>"
               "    <td class='tg-031e'>X</td>"
               "    <th class='tg-031e'>TimeZone </th>"
               "  </tr>"
               "  <tr>"
               "    <td class='tg-031e'>nth</td>"
               "    <td class='tg-031e'>X</td>"
               "    <td class='tg-031e'>X</td>"
               "    <th class='tg-031e'>NIGHTMODE START-HOUR</th>"
               "  </tr>"
               "  <tr>"
               "    <td class='tg-031e'>nthe</td>"
               "    <td class='tg-031e'>X</td>"
               "    <td class='tg-031e'>X</td>"
               "    <th class='tg-031e'>NIGHTMODE STOP HOUR</th>"
               "  </tr>"
               "  <tr>"
               "    <td class='tg-031e'>nthen</td>"
               "    <td class='tg-031e'>X</td>"
               "    <td class='tg-031e'>X</td>"
               "    <th class='tg-031e'>NIGHTMODE STATE</th>"
               "  </tr>"
               "  <tr>"
               "    <td class='tg-031e'>nthstate</td>"
               "    <td class='tg-031e'>X</td>"
               "    <td class='tg-031e'>X</td>"
               "    <th class='tg-031e'>IS NIGHTMODE CURRENTLY ON</th>"
               "  </tr>"
               "  <tr>"
               "    <td class='tg-031e'>nthonmode</td>"
               "    <td class='tg-031e'>X</td>"
               "    <td class='tg-031e'>X</td>"
               "    <th class='tg-031e'>LED MODE IF NIGHTMODE CURRENTLY ON</th>"
               " </tr>"
               "  <tr>"
               "    <td class='tg-031e'>nthoffmode</td>"
               "    <td class='tg-031e'>X</td>"
               "    <td class='tg-031e'>X</td>"
               "    <th class='tg-031e'>LED MODE IF NIGHTMODE CURRENTLY OFF</th>"
               "  </tr>"
               "  <tr>"
               "    <td class='tg-031e'>clock_orientation</td>"
               "    <td class='tg-031e'>X</td>"
               "    <td class='tg-031e'>X</td>"
               "    <th class='tg-031e'>CLOCK DISPLAY ORIENTATION</th>"
               "  </tr>"

               "  <tr>"
               "    <td class='tg-031e'>player1score</td>"
               "    <td class='tg-031e'>X</td>"
               "    <td class='tg-031e'>X</td>"
               "    <td class='tg-031e'>GAME-SCORE PLAYER 1</td>"
               "  </tr>"
               "  <tr>"
               "    <td class='tg-031e'>player2score</td>"
               "    <td class='tg-031e'>X</td>"
               "    <td class='tg-031e'>X</td>"
               "    <td class='tg-031e'>GANE-SCORE PLAYER 2</td>"
               "  </tr>"
               "  <tr>"
               "    <td class='tg-031e'>pong_game_speed</td>"
               "    <td class='tg-031e'>X</td>"
               "    <td class='tg-031e'>X</td>"
               "    <td class='tg-031e'>PONG GAME SPEED</td>"
               "  </tr>"
               "  <tr>"
               "    <td class='tg-031e'>paddle1size</td>"
               "    <td class='tg-031e'>X</td>"
               "    <td class='tg-031e'>X</td>"
               "    <td class='tg-031e'>PONG: PADDLE-SIZE PLAYER 1</td>"
               "  </tr>"
               "  <tr>"
               "    <td class='tg-031e'>paddle2size</td>"
               "    <td class='tg-031e'>X</td>"
               "    <td class='tg-031e'>X</td>"
               "    <td class='tg-031e'>PONG: PADDLE-SIZE PLAYER 2</td>"
               "  </tr>"
               "  <tr>"
               "    <td class='tg-031e'>st_speed</td>"
               "    <td class='tg-031e'>X</td>"
               "    <td class='tg-031e'>X</td>"
               "    <td class='tg-031e'>SCROLLING TEXT SPEED</td>"
               "  </tr>"
               "  <tr>"
               "    <td class='tg-031e'>chenp1</td>"
               "    <td class='tg-031e'>X</td>"
               "    <td class='tg-031e'>X</td>"
               "    <td class='tg-031e'>PONG: ENABLE CHEATING PLAYER 1</td>"
               "  </tr>"
               "  <tr>"
               "    <td class='tg-031e'>chenp2</td>"
               "    <td class='tg-031e'>X</td>"
               "    <td class='tg-031e'>X</td>"
               "    <td class='tg-031e'>PONG: ENABLE CHEATING PLAYER 2</td>"
               "  </tr>"
               "  <tr>"
               "    <td class='tg-031e'>feldx</td>"
               "    <td class='tg-031e'>X</td>"
               "    <td class='tg-031e'></td>"
               "    <td class='tg-031e'>LED MATRIX SIZE X</td>"
               "  </tr>"
               "  <tr>"
               "    <td class='tg-031e'>feldy</td>"
               "    <td class='tg-031e'>X</td>"
               "    <td class='tg-031e'></td>"
               "    <td class='tg-031e'>LED MATRIX SIZE Y</td>"
               "  </tr>"
               "  <tr>"
               "    <td class='tg-031e'>hour</td>"
               "    <td class='tg-031e'>X</td>"
               "    <td class='tg-031e'></td>"
               "    <th class='tg-031e'>CLOCK HOURS</th>"
               "  </tr>"
               "  <tr>"
               "    <td class='tg-031e'>minute</td>"
               "    <td class='tg-031e'>X</td>"
               "    <td class='tg-031e'></td>"
               "    <th class='tg-031e'>CLOCK MINUTES</th>"
               "  </tr>"
               "  <tr>"
               "    <td class='tg-031e'>second</td>"
               "    <td class='tg-031e'>X</td>"
               "    <td class='tg-031e'></td>"
               "    <th class='tg-031e'>CLOCK SECONDS</th>"
               "  </tr>"
               "  <tr>"
               "    <td class='tg-031e'>reset_jumper</td>"
               "    <td class='tg-031e'>X</td>"
               "    <td class='tg-031e'></td>"
               "    <th class='tg-031e'>STATE OF THE RESET JUMPER</th>"
               "  </tr>"
               "  <tr>"
               "    <td class='tg-031e'>st_char_count</td>"
               "    <td class='tg-031e'>X</td>"
               "    <td class='tg-031e'></td>"
               "    <th class='tg-031e'>AMOUNT OF CHARS IN THE SCROLLING TEXT BUFFER</th>"
               "  </tr>"
               "  <tr>"
               "    <td class='tg-031e'>relais</td>"
               "    <td class='tg-031e'>X</td>"
               "    <td class='tg-031e'></td>"
               "    <th class='tg-031e'>STATE OF THE LED-MATRIX RELAIS</th>"
               "  </tr>"
               "  <tr>"
               "    <td class='tg-031e'>rss_enable</td>"
               "    <td class='tg-031e'>X</td>"
               "    <td class='tg-031e'>X</td>"
               "    <th class='tg-031e'>T.I.S STATE</th>"
               "  </tr>"
               "  <tr>"
               "    <td class='tg-031e'>rss_state</td>"
               "    <td class='tg-031e'>X</td>"
               "    <td class='tg-031e'></td>"
               "    <th class='tg-031e'>IS THE T.I.S-MODE CURRENTLY RUNNING</th>"
               "  </tr>"
               "  <tr>"
               "    <td class='tg-031e'>save</td>"
               "    <td class='tg-031e'></td>"
               "    <td class='tg-031e'>X</td>"
               "    <th class='tg-031e'>SAVE SETTINGS (WITHOUT ANY PARAMETER)</th>"
               "  </tr>"
               "  <tr>"
               "    <td class='tg-031e'>gettime</td>"
               "    <td class='tg-031e'></td>"
               "    <td class='tg-031e'>X</td>"
               "    <th class='tg-031e'>SYNC RTC WITH NTP (WITHOUT ANY PARAMETER)</th>"
               "  </tr>"
               "  <tr>"
               "    <td class='tg-031e'>clearscreen</td>"
               "    <td class='tg-031e'></td>"
               "    <td class='tg-031e'>X</td>"
               "    <th class='tg-031e'>CLEAR COMPLETE SCREEN</th>"
               "  </tr>"
               "  <tr>"
               "    <td class='tg-031e'>nullpunkt</td>"
               "    <td class='tg-031e'>X</td>"
               "    <td class='tg-031e'>X</td>"
               "    <th class='tg-031e'>FIRST LED CORNER</th>"
               "  </tr>"
               "  <tr>"
               "    <td class='tg-031e'>bootscr</td>"
               "    <td class='tg-031e'>X</td>"
               "    <td class='tg-031e'>X</td>"
               "    <th class='tg-031e'>BOOTSCREEN STATE</th>"
               "  </tr>"
               "  <tr>"
               "    <td class='tg-031e'>rss_loops</td>"
               "    <td class='tg-031e'>X</td>"
               "    <td class='tg-031e'>X</td>"
               "    <th class='tg-031e'>AMOUNT OF THE T.I.S.-LOOPS</th>"
               "  </tr>"
               "  <tr>"
               "    <td class='tg-031e'>rss_break_game</td>"
               "    <td class='tg-031e'>X</td>"
               "    <td class='tg-031e'>X</td>"
               "    <th class='tg-031e'>CAN T.I.S. BREAK A RUNNING GAME TO DISPLAY INFORMATION</th>"
               "  </tr>"
               "</table>";

//----------------------------------------------------CLOCK------------------------------------

void clock_copy_arr(int value, int time_array) {
  for (int i = 0; i < 4; i++) {
    for (int j = 0; j < 7; j++) {
      switch (value) {
        case 0: template_buffer_array[i][j] = number_template_0[i][j]; break;
        case 1: template_buffer_array[i][j] = number_template_1[i][j]; break;
        case 2: template_buffer_array[i][j] = number_template_2[i][j]; break;
        case 3: template_buffer_array[i][j] = number_template_3[i][j]; break;
        case 4: template_buffer_array[i][j] = number_template_4[i][j]; break;
        case 5: template_buffer_array[i][j] = number_template_5[i][j]; break;
        case 6: template_buffer_array[i][j] = number_template_6[i][j]; break;
        case 7: template_buffer_array[i][j] = number_template_7[i][j]; break;
        case 8: template_buffer_array[i][j] = number_template_8[i][j]; break;
        case 9: template_buffer_array[i][j] = number_template_9[i][j]; break;
        case 10: template_buffer_array[i][j] = number_template_nothing[i][j]; break;
        default: template_buffer_array[i][j] = number_template_nothing[i][j]; break;
      }//ENDE CASE
      switch (time_array) {
        case 1: time1[i][j] = template_buffer_array[i][j]; break;
        case 2: time2[i][j] = template_buffer_array[i][j]; break;
        case 3: time3[i][j] = template_buffer_array[i][j]; break;
        case 4: time4[i][j] = template_buffer_array[i][j]; break;
        default: break;
          // Befehle
      }//ENDE CASE
    }//ENDE J
  }//ENDE I
}

// send an NTP request to the time server at the given address
unsigned long sendNTPpacket(IPAddress& address) {
  // set all bytes in the buffer to 0
  memset(packetBuffer, 0, NTP_PACKET_SIZE);
  // Initialize values needed to form NTP request
  // (see URL above for details on the packets)
  packetBuffer[0] = 0b11100011;   // LI, Version, Mode
  packetBuffer[1] = 0;     // Stratum, or type of clock
  packetBuffer[2] = 6;     // Polling Interval
  packetBuffer[3] = 0xEC;  // Peer Clock Precision
  // 8 bytes of zero for Root Delay & Root Dispersion
  packetBuffer[12]  = 49;
  packetBuffer[13]  = 0x4E;
  packetBuffer[14]  = 49;
  packetBuffer[15]  = 52;
  Udp.beginPacket(address, 123); //NTP requests are to port 123
  Udp.write(packetBuffer, NTP_PACKET_SIZE);
  Udp.endPacket();
}

void get_ntp_time(int en_ds1307 = 0)
{
  sendNTPpacket(timeServer); // send an NTP packet to a time server
  delay(1000);
  if ( Udp.parsePacket() ) {
    Udp.read(packetBuffer, NTP_PACKET_SIZE); // read the packet into the buffer
    unsigned long highWord = word(packetBuffer[40], packetBuffer[41]);
    unsigned long lowWord = word(packetBuffer[42], packetBuffer[43]);
    unsigned long secsSince1900 = highWord << 16 | lowWord;
    const unsigned long seventyYears = 2208988800UL;
    unsigned long epoch = secsSince1900 - seventyYears;
    ntph = (epoch  % 86400L) / 3600; // print the hour (86400 equals secs per day)
    ntpm = (epoch  % 3600) / 60; // print the minute (3600 equals secs per minute)
    if (en_ds1307 == 0) {
      ntps = epoch % 60;
    }
    //Serial.print("NTP:"); Serial.print(ntph); Serial.print(":"); Serial.println(ntpm);
    //hier die zeitverschiebung beachten
    ntph  = ntph + zeitverschiebung;
    if (ntph == 24) {
      ntph = 0;
    } if (ntph > 24) {
      ntph = ntph - 24;
    } if (ntph < 0) {
      ntph = 24 - ntph;
    }
    dayOfWeek = 1;
    dayOfMonth = 1;
    month = 1;
    year = 1;
    Wire.beginTransmission(DS1307_I2C_ADDRESS);
    I2C_WRITE(zero);
    I2C_WRITE(decToBcd(ntps) & 0x7f);    // 0 to bit 7 starts the clock
    I2C_WRITE(decToBcd(ntpm));
    I2C_WRITE(decToBcd(ntph));      // If you want 12 hour am/pm you need to set// bit 6 (also need to change readDateDs1307)
    I2C_WRITE(decToBcd(dayOfWeek));
    I2C_WRITE(decToBcd(dayOfMonth));
    I2C_WRITE(decToBcd(month));
    I2C_WRITE(decToBcd(year));
    Wire.endTransmission();
  }
}

void display_clock(int hz = 0, int he  = 0, int mz  = 0, int me = 0) {
  if (clockcolormode == 0) {
    if (clock_color_counter >= 256) {
      clock_color_counter = 0;
    } else {
      clock_color_counter++;
    }
    clock_h_color = Wheel(clock_color_counter);
    clock_m_color = Wheel(256 - clock_color_counter);
  } else if (clockcolormode == 1) {
    if (clock_fix_color_h == 0) {
      clock_h_color =  strip.Color(clock_bright, 0, 0);
    } else  if (clock_fix_color_h == 1) {
      clock_h_color =  strip.Color(0, clock_bright, 0);
    } else  if (clock_fix_color_h == 2) {
      clock_h_color =  strip.Color(0, 0, clock_bright);
    } else  if (clock_fix_color_h == 3) {
      clock_h_color =  strip.Color(0, clock_bright, clock_bright);
    } else  if (clock_fix_color_h == 4) {
      clock_h_color =  strip.Color(clock_bright, 0, clock_bright);
    } else  if (clock_fix_color_h == 5) {
      clock_h_color =  strip.Color(clock_bright, clock_bright, 0);
    } else  if (clock_fix_color_h == 6) {
      clock_h_color =  strip.Color(clock_bright, clock_bright, clock_bright);
    } else {
      clock_h_color =  strip.Color(0, 0, 255);
    }
    if (clock_fix_color_m == 0) {
      clock_m_color =  strip.Color(clock_bright, 0, 0);
    } else  if (clock_fix_color_m == 1) {
      clock_m_color =  strip.Color(0, clock_bright, 0);
    } else  if (clock_fix_color_m == 2) {
      clock_m_color =  strip.Color(0, 0, clock_bright);
    } else  if (clock_fix_color_m == 3) {
      clock_m_color =  strip.Color(0, clock_bright, clock_bright);
    } else  if (clock_fix_color_m == 4) {
      clock_m_color =  strip.Color(clock_bright, 0, clock_bright);
    } else  if (clock_fix_color_m == 5) {
      clock_m_color =  strip.Color(clock_bright, clock_bright, 0);
    } else  if (clock_fix_color_m == 6) {
      clock_m_color =  strip.Color(clock_bright, clock_bright, clock_bright);
    } else {
      clock_m_color =  strip.Color(0, 0, 255);
    }
  } else {
    clockcolormode = 0;
  }
  clock_copy_arr(hz, 1);
  clock_copy_arr(he, 2);
  clock_copy_arr(mz, 3);
  clock_copy_arr(me, 4);
  for (int i = 0; i < 4; i++) {
    for (int j = 0; j < 7; j++) {
      if (time4[i][j] == 1) {
        strip.setPixelColor(get_led_number(i + time1_anchor[0], j + time1_anchor[1]),  clock_h_color);
      } else {
        strip.setPixelColor(get_led_number(i + time1_anchor[0], j + time1_anchor[1]),  strip.Color(0, 0, 0));
      }
    }
  }
  for (int i = 0; i < 4; i++) {
    for (int j = 0; j < 7; j++) {
      if (time3[i][j] == 1) {
        strip.setPixelColor(get_led_number(i + time2_anchor[0], j + time2_anchor[1]),  clock_h_color);
      } else {
        strip.setPixelColor(get_led_number(i + time2_anchor[0], j + time2_anchor[1]),  strip.Color(0, 0, 0));
      }
    }
  }
  for (int i = 0; i < 4; i++) {
    for (int j = 0; j < 7; j++) {
      if (time2[i][j] == 1) {
        strip.setPixelColor(get_led_number(i + time3_anchor[0], j + time3_anchor[1]),  clock_m_color);
      } else {
        strip.setPixelColor(get_led_number(i + time3_anchor[0], j + time3_anchor[1]),  strip.Color(0, 0, 0));
      }
    }
  }
  for (int i = 0; i < 4; i++) {
    for (int j = 0; j < 7; j++) {
      if (time1[i][j] == 1) {
        strip.setPixelColor(get_led_number(i + time4_anchor[0], j + time4_anchor[1]),  clock_m_color);
      } else {
        strip.setPixelColor(get_led_number(i + time4_anchor[0], j + time4_anchor[1]),  strip.Color(0, 0, 0));
      }
    }
  }
  strip.show();
  delay(clock_color_speed);
}
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
void loop() {
  main_process();
  if (mode == 5) { //OFF
    digitalWrite(relais, LOW);
    colorfill(strip.Color(0, 0, 0)); // G;R;B
    set_standby_led(strip.Color(standby_strip_fade, 0, 0));
    if (standby_strip_fade == 0 && standby_strip_fade_richtung == 1)
      standby_strip_fade_richtung = 0;
    else if (standby_strip_fade == 15 && standby_strip_fade_richtung == 0)
      standby_strip_fade_richtung = 1;
    switch(standby_strip_fade_richtung) {
     case 0: standby_strip_fade ++; break;
     case 1: standby_strip_fade --; break; 
    }
    smartdelay(200);
  } else if (mode == 0) { //STANDBY
    digitalWrite(relais, HIGH);
    clear_screen();
    strip.setPixelColor(get_led_number(0, 0), strip.Color(0, 0, 10));
    strip.setPixelColor(get_led_number(0, 9), strip.Color(0, 0, 10));
    strip.setPixelColor(get_led_number(19, 9), strip.Color(0, 0, 10));
    strip.setPixelColor(get_led_number(19, 0), strip.Color(0, 0, 10));
    set_standby_led( strip.Color(0, 0, 70));
    strip.show();
    digitalWrite(relais, HIGH);
  } else if (mode == 1) { // CONST COLOR
    colorfill(strip.Color(fillred, fillgreen, fillblue)); // G;R;B
    digitalWrite(relais, HIGH);
  } else if (mode == 2) { //RAINBOW
    if (rainbowmode == 0) {
      rainbow();
    } else if (rainbowmode == 1) {
      rainbowCycle();
    } else if (rainbowmode == 2) {
      rainbow_complete();
    } else if (rainbowmode == 3) {
      rainbowCycleCol();
    } else {
      rainbowmode = 0;
    }
    digitalWrite(relais, HIGH);
  } else if (mode == 3) { //RANDOM
    randomCycle();
    digitalWrite(relais, HIGH);
  } else if (mode == 4) { //PONG
    digitalWrite(relais, HIGH);
    pong_loop();
    main_process();
  } else if (mode == 12) { //Paint
    digitalWrite(relais, HIGH);
    paint_loop();
    strip.show();
    main_process();
  } else if (mode == 10) { //Square
    digitalWrite(relais, HIGH);
    square_loop();
    strip.show();
    main_process();
  } else if (mode == 11) { //Senso
    digitalWrite(relais, HIGH);
    senso_loop();
    strip.show();
    main_process();
  } else if (mode == 6) { //Clock
    digitalWrite(relais, HIGH);
    _value = hour;
    h_z = (_value % 100) / 10;
    h_e = _value % 10;
    binwert_h_z = byte(h_z);
    binwert_h_e = byte(h_e);
    _value = minute;
    m_z = (_value % 100) / 10;
    m_e = _value % 10;
    binwert_m_z = byte(m_z);
    binwert_m_e = byte(m_e);
    //Serial.print(m_z); Serial.println(m_e);
    //h_z = 0
    display_clock(h_z, h_e, m_z, m_e);
  } else if (mode == 7) {
    digitalWrite(relais, HIGH);
    //DMX
  } else if (mode == 8) {
    digitalWrite(relais, HIGH);
    //SCROLLING TEXT
    st_play();
  } else {
    //ERR
    show_error("could not find mode");
  }//end mode
  
  strip.show();
}//ENDE LOOP

void show_error(String reason ) {
  int relais_state_buffer = 1;
  if (digitalRead(relais) == HIGH) {
    relais_state_buffer = 1;
  } else {
    relais_state_buffer = 0;
  }
  digitalWrite(relais, HIGH);
  clear_screen();
  strip.setPixelColor(get_led_number(0, 0), strip.Color(255, 0, 0));
  strip.setPixelColor(get_led_number(0, 9), strip.Color(255, 0, 0));
  strip.setPixelColor(get_led_number(19, 9), strip.Color(255, 0, 0));
  strip.setPixelColor(get_led_number(19, 0), strip.Color(255, 0, 0));
  if (standby_strip_state == 0) {
    set_standby_led( strip.Color(255, 0, 0));
    standby_strip_state = 1;
  } else {
    set_standby_led( strip.Color(0, 0, 0));
    standby_strip_state = 0;
  }
  
  strip.show();
  delay(2000);
  Serial.print("ERROR : "); Serial.println(reason);
  if (relais_state_buffer == 1) {
    digitalWrite(relais, HIGH);
  } else {
    digitalWrite(relais, LOW);
  }
}

void show_nullpunkt() {
  int relais_state_buffer = 1;
  if (digitalRead(relais) == HIGH) {
    relais_state_buffer = 1;
  } else {
    relais_state_buffer = 0;
  }
  digitalWrite(relais, HIGH);
  clear_screen();
  strip.show();
  delay(100);
  strip.setPixelColor(0, strip.Color(255, 255, 255));
  strip.show();
  delay(2000);
  if (relais_state_buffer == 1) {
    digitalWrite(relais, HIGH);
  } else {
    digitalWrite(relais, LOW);
  }
}

// Fill the dots one after the other with a color
void colorfill(uint32_t c) {
  for (uint16_t i = 0; i < strip.numPixels(); i++) {
    strip.setPixelColor(i, c);
    set_standby_led( c);
  }
  strip.show();
}

void rainbow() {
  uint16_t i, j;
  for (j = 0; j < 256; j++) {
    if (mode != 2 || rainbowmode != 0) break;
    for (i = 0; i < strip.numPixels(); i++) {
    if (mode != 2 || rainbowmode != 0) break;
      strip.setPixelColor(i, Wheel((i + j) & 255));
    }
    strip.show();
    main_process();
    delay(rainbowspeed);
  }
}

void rainbow_complete() {
  uint16_t i, j;
  for (j = 0; j < 256; j++) {
    if(mode != 2 || rainbowmode != 2) break;
    for (i = 0; i < strip.numPixels(); i++) {
    if(mode != 2 || rainbowmode != 2) break;
      strip.setPixelColor(i, Wheel((j) & 255));
    }
    strip.show();
    main_process();
    delay(rainbowspeed);
  }
}

// Slightly different, this makes the rainbow equally distributed throughout
void randomCycle() {
  uint16_t i, j;
  if (randommode == 2) {
    int color =  Wheel(random(0, 257));
    for (i = 0; i < strip.numPixels(); i++) {
      strip.setPixelColor(i, color);
    }
    strip.show(); main_process(); delay(randomspeed);
  } else {
    for (i = 0; i < strip.numPixels(); i++) {
      if (randomefmode == 1) {
        strip.setPixelColor(random(0, 201), Wheel(random(0, 257)));
      } else if ( randomefmode == 0) {
        strip.setPixelColor(i, Wheel(random(0, 257)));
      }
      if (randommode == 0) {
        strip.show();
        main_process();
        delay(randomspeed);
      }
    }
    if (randommode == 1) {
      strip.show();
      main_process();
      delay(randomspeed);
    }
  }
}

void rainbowCycle() {
  uint16_t i, j;
  for (j = 0; j < 256 * 5; j++) { // 5 cycles of all colors on wheel
  if (mode != 2 || rainbowmode != 1) break;
    for (i = 0; i < strip.numPixels(); i++) {
    if (mode != 2 || rainbowmode != 1) break;
    strip.setPixelColor(i, Wheel(((i * 256 / strip.numPixels()) + j) & 255));
    }
    strip.show();
    main_process();
    delay(rainbowspeed);
  }
}

uint16_t i1, j;

void rainbowCycleCol() {
  i1++;
  for (int x = 0; x < feldx; x++) {
    if (mode != 2 || rainbowmode != 3) break;
    for (int y = 0; y < feldy; y++) {
      if (mode != 2 || rainbowmode != 3) break;
      strip.setPixelColor(get_led_number(x, y), Wheel(i1));
      if (i1 > 255) {
        i1 = 0;
      } else {
        i1++;
      }
    }
    strip.show();
    main_process();
    delay(rainbowspeed);
  }
}

// Input a value 0 to 255 to get a color value.
// The colours are a transition r - g - b - back to r.
uint32_t Wheel(byte WheelPos) {
  if (WheelPos < 85) {
    return strip.Color(WheelPos * 3, 255 - WheelPos * 3, 0);
  } else if (WheelPos < 170) {
    WheelPos -= 85;
    return strip.Color(255 - WheelPos * 3, 0, WheelPos * 3);
  } else {
    WheelPos -= 170;
    return strip.Color(0, WheelPos * 3, 255 - WheelPos * 3);
  }
}
void clear_screen() {
  uint16_t i, j;
  for (i = 0; i < strip.numPixels(); i++) {
    strip.setPixelColor(i, strip.Color(0, 0, 0));
  }
  strip.show();
}

int nthswstate = 0;
int nthswstate1 = 0;

void getDateDs1307()
{
  // Reset the register pointer
  Wire.beginTransmission(DS1307_I2C_ADDRESS);
  I2C_WRITE(zero);
  Wire.endTransmission();
  Wire.requestFrom(DS1307_I2C_ADDRESS, 7);
  // A few of these need masks because certain bits are control bits
  second     = bcdToDec(I2C_READ() & 0x7f);
  minute     = bcdToDec(I2C_READ());
  hour       = bcdToDec(I2C_READ() & 0x3f);  // Need to change this if 12 hour am/pm
  dayOfWeek  = bcdToDec(I2C_READ());
  dayOfMonth = bcdToDec(I2C_READ());
  month      = bcdToDec(I2C_READ());
  year       = bcdToDec(I2C_READ());
  
  if (nthen == 1) {
    //LIEGT DIE ZEIT ZWISCHEN DEN BEIDEN GERENDZEN
    if (nth > nthe-1) {
      //WENN ANFANG > ALS ENDE
      if (hour <= nth && hour <= nthe-1) {
        nthstate = 1;
      } else if (hour >= nth && hour >= nthe-1) {
        nthstate = 1;
      } else {
        nthstate = 0;
      }
    } else if (nth < nthe-1) {
      //WENN ANFANG > ALS ENDE
      if (hour <= nth && hour >= nthe-1) {
        nthstate = 1;
      } else if (hour >= nth && hour <= nthe-1) {
        nthstate = 1;
      } else {
        nthstate = 0;
      }
    } else if ( nth == nthe-1) {
      if (hour == nth || hour == nthe-1) {
        nthstate = 1;
      } else {
        nthstate = 0;
      }
    } else {
      nthstate = 0;
    }
  } else {
    nthstate == 0;
  }
  if (nthstate == 1 && nthen == 1) {
    //NACHTMODE AKTIV
    if (nthswstate1 == 0) {
      mode = nthonmode;
      nthswstate = 0;
      nthswstate1 = 1;
    }
  } else {
    if (nthswstate == 0) {
      mode = nthoffmode;
      nthswstate = 1;
      nthswstate1 = 0;
    }
    //NIGHTAKTIVE
  }
}

void defaultCmd(WebServer &server, WebServer::ConnectionType type, char *, bool)
{
  if (type == WebServer::POST)
  {
  }
  server.httpSuccess();
  if (type == WebServer::GET)
  {
    server.printP(phead1);
    server << webTitle;
    server.printP(phead2);
   // server.printP("<meta http-equiv='refresh' content='60' >");
    server.printP(pstart);
    server.print("<span class='title'>Dashboard</span><hr><br><br>");
    server << "<p><h2> Current table-mode : ";
    if (mode == 5) {
    }
    if (mode == 5) {
      server << " OFF ";
    } else if (mode == 0) {
      server << " STANDBY ";
    } else if (mode == 1) {
      server << " constant color ";
    } else if (mode == 2) {
      server << " rainbow ";
    } else if (mode == 3) {
      server << " random ";
    } else if (mode == 4) {
      server << " pong (";
      if (pongmode == 0) {
        server << "2 player";
      } else if (pongmode == 1) {
        server << "auto-mode";
      }
      server << " ) ";
    } else if (mode == 6) {
      server << " CLOCK ";
    } else if (mode == 7) {
      server << " DMX ";
    } else if (mode == 8) {
      server << " TSCROLLING TEXT";
    } else if (mode == 9) {
      server << " T.I.S.";
    } else if (mode == 10) {
      server << " SQUARE (GAME) ";
    } else if (mode == 11) {
      server << " SENSO (GAME) ";
    } else if (mode == 12) {
      server << " PAINT ";
    }
    server << "<h2>TABLE TIME :"; if (hour < 10) {
      server << "0";
    } server << hour << ":"; if (minute < 10) {
      server << "0";
    } server << minute << ":"; 
    if (second < 10) {
      server << "0";
    }  server << second; 
    server <<"</h2><br /><hr /><br /><h3>";
    server <<"Table OS Version: ";
    server <<versionsnummer;
    server <<"</h3>";
    server.printP(pend);
    
  }
}

int api_get_value = 0;

void apigetCmd(WebServer &server, WebServer::ConnectionType type, char *, bool)
{
  if (type == WebServer::POST)
  {
    bool repeat;
    char name[32], value[32];
    do
    {
      repeat = server.readPOSTparam(name, 32, value, 32);
      if (api_enable == 1) {
        if (strcmp(name, "baud_rate") == 0) {
          api_get_value = baud_rate;
        }
        if (strcmp(name, "fan_state") == 0) {
          api_get_value = fan_state;
        }
        if (strcmp(name, "mode") == 0) {
          api_get_value = mode;
        }
        if (strcmp(name, "rainbowspeed") == 0) {
          api_get_value = rainbowspeed;
        }
        if (strcmp(name, "randomspeed") == 0) {
          api_get_value = randomspeed;
        }
        if (strcmp(name, "randomefmode") == 0) {
          api_get_value = randomefmode;
        }
        if (strcmp(name, "use_ethernet") == 0) {
          api_get_value = use_ethernet;
        }
        if (strcmp(name, "enable_dhcp") == 0) {
          api_get_value = enable_dhcp;
        }
        if (strcmp(name, "wait_for_DHCP") == 0) {
          api_get_value = wait_for_DHCP;
        }
        if (strcmp(name, "zeitverschiebung") == 0) {
          api_get_value = zeitverschiebung;
        }
        if (strcmp(name, "nth") == 0) {
          api_get_value = nth;
        }
        if (strcmp(name, "nthe") == 0) {
          api_get_value = nthe;
        }
        if (strcmp(name, "nthen") == 0) {
          api_get_value = nthen;
        }
        if (strcmp(name, "nthstate") == 0) {
          api_get_value = nthstate;
        }
        if (strcmp(name, "nthonmode") == 0) {
          api_get_value = nthonmode;
        }
        if (strcmp(name, "nthoffmode") == 0) {
          api_get_value = nthoffmode;
        }
        if (strcmp(name, "player1score") == 0) {
          api_get_value = player1score;
        }
        if (strcmp(name, "player2score") == 0) {
          api_get_value = player2score;
        }
        if (strcmp(name, "pong_game_speed") == 0) {
          api_get_value = pong_game_speed;
        }
        if (strcmp(name, "paddle1size") == 0) {
          api_get_value = paddle1size;
        }
        if (strcmp(name, "paddle2size") == 0) {
          api_get_value = paddle2size;
        }
        if (strcmp(name, "st_speed") == 0) {
          api_get_value = st_speed;
        }
        if (strcmp(name, "chenp2") == 0) {
          api_get_value = chenp2;
        }
        if (strcmp(name, "chenp1") == 0) {
          api_get_value = chenp1;
        }
        if (strcmp(name, "feldx") == 0) {
          api_get_value = feldx;
        }
        if (strcmp(name, "feldy") == 0) {
          api_get_value = feldy;
        }
        if (strcmp(name, "second") == 0) {
          api_get_value = second;
        }
        if (strcmp(name, "minute") == 0) {
          api_get_value = minute;
        }
        if (strcmp(name, "hour") == 0) {
          api_get_value = hour;
        }
        if (strcmp(name, "reset_jumper") == 0) {
          api_get_value = reset_jumper;
        }
        if (strcmp(name, "st_char_count") == 0) {
          api_get_value = st_char_count;
        }
        if (strcmp(name, "relais") == 0) {
          api_get_value = relais;
        }
        if (strcmp(name, "rss_enable") == 0) {
          api_get_value = rss_enable;
        }
        if (strcmp(name, "rss_state") == 0) {
          api_get_value = rss_state;
        }
        if (strcmp(name, "nullpunkt") == 0) {
          api_get_value = nullpunkt;
        }
        if (strcmp(name, "bootscr") == 0) {
          api_get_value = table_os_enable;
        }
        if (strcmp(name, "rss_loops") == 0) {
          rss_max_loops = table_os_enable;
        }
        if (strcmp(name, "rss_break_game") == 0) {
          rss_can_break_during_game = table_os_enable;
        }
      }
    } while (repeat);
    clear_screen();
    save_settings();
    server.httpSeeOther("/apiget.html");
    return;
  }
  server.httpSuccess();
  if (type == WebServer::GET)
  {
    server << "<html><head><title>LED TABLE API (GET)</title></head><body>";
    server << api_get_value;
    server << "</body></html>";
  }
}

int api_set_value = 0;
void apisetCmd(WebServer &server, WebServer::ConnectionType type, char *, bool)
{
  if (type == WebServer::POST)
  {
    bool repeat;
    char name[32], value[32];
    do
    {
      repeat = server.readPOSTparam(name, 32, value, 32);
      if (api_enable == 1) {
        if (strcmp(name, "fan_state") == 0) {
          fan_state = strtoul(value, NULL, 10);
        }
        if (strcmp(name, "mode") == 0) {
          mode = strtoul(value, NULL, 10) ;
        }
        if (strcmp(name, "rainbowspeed") == 0) {
          rainbowspeed = strtoul(value, NULL, 10) ;
        }
        if (strcmp(name, "randomspeed") == 0) {
          randomspeed = strtoul(value, NULL, 10) ;
        }
        if (strcmp(name, "randomefmode") == 0) {
          randomefmode = strtoul(value, NULL, 10) ;
        }
        if (strcmp(name, "zeitverschiebung") == 0) {
          zeitverschiebung = strtoul(value, NULL, 10) ;
        }
        if (strcmp(name, "nth") == 0) {
          nth = strtoul(value, NULL, 10) ;
        }
        if (strcmp(name, "nthe") == 0) {
          nthe = strtoul(value, NULL, 10) ;
        }
        if (strcmp(name, "nthen") == 0) {
          nthen = strtoul(value, NULL, 10) ;
        }
        if (strcmp(name, "nthstate") == 0) {
          nthstate = strtoul(value, NULL, 10) ;
        }
        if (strcmp(name, "nthonmode") == 0) {
          nthonmode = strtoul(value, NULL, 10) ;
        }
        if (strcmp(name, "nthoffmode") == 0) {
          nthoffmode = strtoul(value, NULL, 10) ;
        }
        if (strcmp(name, "player1score") == 0) {
          player1score = strtoul(value, NULL, 10) ;
        }
        if (strcmp(name, "player2score") == 0) {
          player2score = strtoul(value, NULL, 10) ;
        }
        if (strcmp(name, "pong_game_speed") == 0) {
          pong_game_speed = strtoul(value, NULL, 10) ;
        }
        if (strcmp(name, "paddle1size") == 0) {
          paddle1size = strtoul(value, NULL, 10) ;
        }
        if (strcmp(name, "paddle2size") == 0) {
          paddle2size = strtoul(value, NULL, 10) ;
        }
        if (strcmp(name, "st_speed") == 0) {
          st_speed = strtoul(value, NULL, 10) ;
        }
        if (strcmp(name, "chenp2") == 0) {
          chenp2 = strtoul(value, NULL, 10) ;
        }
        if (strcmp(name, "chenp1") == 0) {
          chenp1 = strtoul(value, NULL, 10) ;
        }
        if (strcmp(name, "rss_enable") == 0) {
          rss_enable = strtoul(value, NULL, 10) ;
        }
        if (strcmp(name, "gettime") == 0) {
          get_ntp_time();
        }
        if (strcmp(name, "save") == 0) {
          save_settings();
        }
        if (strcmp(name, "clearscreen") == 0) {
          clear_screen();
        }
        if (strcmp(name, "nullpunkt") == 0) {
          nullpunkt = strtoul(value, NULL, 10) ;
        }
        if (strcmp(name, "bootscr") == 0) {
          table_os_enable = strtoul(value, NULL, 10) ;
        }
        if (strcmp(name, "rss_loops") == 0) {
          rss_max_loops = strtoul(value, NULL, 10) ;
        }
        if (strcmp(name, "rss_break_game") == 0) {
          rss_can_break_during_game = strtoul(value, NULL, 10) ;
        }
      }
    } while (repeat);
    clear_screen();
    save_settings();
    server.httpSeeOther("/apiset.html");
    return;
  }
  server.httpSuccess();
  if (type == WebServer::GET)
  {
    server << "<html><head><title>LED TABLE API (SET)</title></head><body></body></html>";
  }
}

void apiCmd(WebServer &server, WebServer::ConnectionType type, char *, bool)
{
  if (type == WebServer::POST)
  {
    bool repeat;
    char name[32], value[32];
    do
    {
      repeat = server.readPOSTparam(name, 32, value, 32);
    } while (repeat);
    clear_screen();
    save_settings();
    server.httpSeeOther("/api.html");
    return;
  }
  server.httpSuccess();
  if (type == WebServer::GET)
  {
    server.printP(phead1);
    server << webTitle;
    server.printP(phead2);
    server.printP(pstart);
    server.print("<span class='title'>API (BETA) DOCUMENTATION</span><p><center>");
    server << "<hr><h2>";
    server << "Mit der LED-Table-API kannst per POST-Request ganz einfach die wichtigsten Status-Variablen abfragen/setzten. <br> In der Tabelle siehst du welche Variablen du abfragen/setzten kannst. <br> Ein Request einer Variable wird dann per POST an /apiget.html und /apiset.html gemacht";
    server << "</h2><br><br>";
    server.printP(api_table);
    server << "</center</p>";
    server.printP(pend);
  }
}

void tisCmd(WebServer &server, WebServer::ConnectionType type, char *, bool)
{
  if (type == WebServer::POST)
  {
    bool repeat;
    char name[32], value[32];
    do
    {
      repeat = server.readPOSTparam(name, 32, value, 32);
    } while (repeat);
    clear_screen();
    save_settings();
    server.httpSeeOther("/api.html");
    return;
  }
  server.httpSuccess();
  if (type == WebServer::GET)
  {
    server.printP(phead1);
    server << webTitle;
    server.printP(phead2);
    server.printP(pstart);
    server.print("<span class='title'>TABLE INFORMATION SYSTEN DOCUMENTATION</span><p><center>");
    server << "<hr><h2>";
    server << "Mit dem TABLE INFORMATION SYSTEM (TIS) koennen wichtige Informationen auf dem Tisch per Laufschrift angezeigt werden (aehnlich dem Scrolling-Text Mode).<br> Wenn neue Informationen eingehen zeigt der Tisch sie direkt an und wechselt danach wieder zurueck in den vorherigen Modus.<br> Die Infoswerden ueber Serialport 1 an Arduino Due gesendet, und dieser zeigt die Informationen an. <br> Die Anzeigeoptionen findest du in den Settings. <br>";
    server << "</h2><br><br>";
    server << "</center</p>";
    server.printP(pend);
  }
}

void rgbCmd(WebServer &server, WebServer::ConnectionType type, char *, bool)
{
  if (type == WebServer::POST)
  {
    bool repeat;
    char name[64], value[64];
    do
    {
      repeat = server.readPOSTparam(name, 64, value, 64);
      if (strcmp(name, "mode") == 0) {
        if (mode == 5 && strtoul(value, NULL, 10) != 5) {
          delay(2000);
          digitalWrite(relais, HIGH);
          clear_screen();
          show_bootscreen(0);
        }
        mode = strtoul(value, NULL, 10);
        if (mode == 1) {
          fillred = 0;
          fillgreen = 0;
          fillblue = 0;
        } else if (mode == 4) {
          digitalWrite(relais, HIGH);
          pong_main_reset();
        } else if (mode == 12) {
          digitalWrite(relais, HIGH);
          paint_main_reset();
        } else if (mode == 11) {
          digitalWrite(relais, HIGH);
          senso_main_reset();
        } else if (mode == 10) {
          digitalWrite(relais, HIGH);
          square_main_reset();
        }
        clear_screen();
      }
      if (strcmp(name, "red") == 0) {
        fillred = strtoul(value, NULL, 10);
      }
      if (strcmp(name, "green") == 0) {
        fillgreen = strtoul(value, NULL, 10);
      }
      if (strcmp(name, "blue") == 0) {
        fillblue = strtoul(value, NULL, 10);
      }
      if (strcmp(name, "rmode") == 0) {
        rainbowmode = strtoul(value, NULL, 10);
      }
      if (strcmp(name, "ccm") == 0) {
        clock_fix_color_m = strtoul(value, NULL, 10);
      }
      if (strcmp(name, "cch") == 0) {
        clock_fix_color_h = strtoul(value, NULL, 10);
      }
      if (strcmp(name, "clockcolor") == 0) {
        clockcolormode = strtoul(value, NULL, 10);
      }
      if (strcmp(name, "ranmode") == 0) {
        randommode = strtoul(value, NULL, 10);
        clear_screen();
      }
      if (strcmp(name, "ranefmode") == 0) {
        randomefmode = strtoul(value, NULL, 10);
      }
      if (strcmp(name, "chenp1") == 0) {
        chenp1 = strtoul(value, NULL, 10);
      }
      if (strcmp(name, "chenp2") == 0) {
        chenp2 = strtoul(value, NULL, 10);
      }
      if (strcmp(name, "pongenreset") == 0) {
        pongenreset = strtoul(value, NULL, 10);
      }
      if (strcmp(name, "paddle1size") == 0) {
        paddle1size = strtoul(value, NULL, 10);
      }
      if (strcmp(name, "paddle2size") == 0) {
        paddle2size = strtoul(value, NULL, 10);
      }
      if (strcmp(name, "clockspeed") == 0) {
        clock_color_speed = strtoul(value, NULL, 10);
      }
      if (strcmp(name, "pongresetp1") == 0) {
        player1score = 0;
      }
      if (strcmp(name, "pongresetp2") == 0) {
        player2score = 0;
      }
      if (strcmp(name, "pong_game_speed") == 0) {
        pong_game_speed = strtoul(value, NULL, 10);
      }
      if (strcmp(name, "pongmode") == 0) {
        pongmode = strtoul(value, NULL, 10);
      }
      if (strcmp(name, "rsp") == 0) {
        rainbowspeed = strtoul(value, NULL, 10);
      }
      if (strcmp(name, "cb") == 0) {
        clock_bright = strtoul(value, NULL, 10);
      }
      if (strcmp(name, "ransp") == 0) {
        randomspeed = strtoul(value, NULL, 10);
      }
      if (strcmp(name, "sts") == 0) {
        st_speed = strtoul(value, NULL, 10);
      }
      if (strcmp(name, "stcm") == 0) {
        st_color_mode = strtoul(value, NULL, 10);
      }
      if (strcmp(name, "strs") == 0) {
        st_rain_speed = strtoul(value, NULL, 10);
      }
      if (strcmp(name, "stb") == 0) {
        st_bright = strtoul(value, NULL, 10);
      }
      if (strcmp(name, "stfc") == 0) {
        st_fix_color = strtoul(value, NULL, 10);
      }
      if (strcmp(name, "paintcm") == 0) {
        paint_color_display_mode = strtoul(value, NULL, 10);
      }
      if (strcmp(name, "sensoincstse") == 0) {
        senso_include_startselect = strtoul(value, NULL, 10);
      }
      
      
      if (strcmp(name, "sttext") == 0) {
        st_char_count = 0;
        for (int i = 0; i < sizeof(value); i++) {
          st_chars[i] = 0;
          if (check_char(value[i]) == 1) {
            st_char_count++;
            st_chars[i] = value[i];
            Serial.println(value[i]);
          }
          if(i >= st_maxchar){break;}    
        }
        st_text_to_arr();
      }
    } while (repeat);
    clear_screen();
    save_settings();
    server.httpSeeOther("/rgb");
    return;
  }
  server.httpSuccess();
  if (type == WebServer::GET)
  {
    server.printP(phead1);
    server << webTitle;
    server.printP(phead2);
    server.printP(pstart);
    server.print("<span class='title'>MODE</span><p>");
    server << "<hr>";
    server << " <form id='colorsettings' name='colorsettings' action='' method='post'>";
    server << "<table width='50%' border='0'>";
    server << "<tr>";
    server << "<td><label for='mode'>TABLE MODE</label> </td>";
    server << "<td scope='col'><input type='radio' name='mode' id='mode' value='5' "; if (mode == 5) {
      server << "checked";
    } if (rss_enable == 1 && rss_state == 1) {
      server << " disabled";
    } server << ">OFF</td>  ";
    server << "<td scope='col'><input type='radio' name='mode' id='mode' value='0' "; if (mode == 0) {
      server << "checked";
    } if (rss_enable == 1 && rss_state == 1) {
      server << " disabled";
    } server << ">STANDBY (STILL ALIVE)</td>  ";
    server << "<td scope='col'><input type='radio' name='mode' id='mode'  value='1' "; if (mode == 1) {
      server << "checked";
    } if (rss_enable == 1 && rss_state == 1) {
      server << " disabled";
    } server << ">CONST COLOR </td>";
    server << "<td scope='col'><input type='radio' name='mode' id='mode'  value='2' "; if (mode == 2) {
      server << "checked";
    } if (rss_enable == 1 && rss_state == 1) {
      server << " disabled";
    } server << ">RAINBOW</td>";
    server << "<td scope='col'><input type='radio' name='mode' id='mode'  value='3' "; if (mode == 3) {
      server << "checked";
    } if (rss_enable == 1 && rss_state == 1) {
      server << " disabled";
    } server << ">RANDOM</td>";
    server << "<td scope='col'><input type='radio' name='mode' id='mode'  value='6' "; if (mode == 6) {
      server << "checked";
    } if (rss_enable == 1 && rss_state == 1) {
      server << " disabled";
    } server << ">CLOCK</td>";
    server << "<td scope='col'><input type='radio' name='mode' id='mode'  value='8' "; if (mode == 8) {
      server << "checked";
    } if (rss_enable == 1 && rss_state == 1) {
      server << " disabled";
    } server << ">SCROLLING TEXT</td>";
    server << "<td scope='col'><input type='radio' name='mode' id='mode'  value='4' "; if (mode == 4) {
      server << "checked";
    } if (rss_enable == 1 && rss_state == 1) {
      server << " disabled";
    } server << ">PONG (GAME)</td>";
    server << "<td scope='col'><input type='radio' name='mode' id='mode'  value='12' "; if (mode == 12) {
      server << "checked";
    } if (rss_enable == 1 && rss_state == 1) {
      server << " disabled";
    } server << ">PAINT (GAME)</td>";
    server << "<td scope='col'><input type='radio' name='mode' id='mode'  value='11' "; if (mode == 11) {
      server << "checked";
    } if (rss_enable == 1 && rss_state == 1) {
      server << " disabled";
    } server << ">SENSO (GAME)</td>";
    server << "<td scope='col'><input type='radio' name='mode' id='mode'  value='10' "; if (mode == 10) {
      server << "checked";
    } if (rss_enable == 1 && rss_state == 1) {
      server << " disabled";
    } server << ">SQUARE (LIKE 2048) (GAME)</td>";
    if (rss_enable == 1 && rss_state == 1) {
      server << "<td scope='col'><input type='radio' name='mode' id='mode'  value='9' ";
      if (mode == 9) {
        server << "checked";
      } server << ">T.I.S.</td>";
    }
    server << "<td><input type='submit' value='SAVE' /></td> ";
    server << "</tr>  ";
    server << "</table>";
    server << "</form>";
    server.print("<br><br>");
    server.print("<span class='title'>MODE OPTIONS</span>");
    if (mode == 1) {
      server.print("<p>");
      server.print("<div width='50%' id=red></div>");
      server.print("<div width='50%' id=green></div>");
      server.print("<div  width='50%' id=blue></div>");
      server.println("</p>");
    } else if (mode == 12) {
      server << "<form id='opt' name='opt' action='' method='post'>";
      server << "<table width='50%' border='0'>";
      server << "<tr>";
      server << "<td><label for='paintcm'>CURSOR DISPLAY MODE</label> </td>";
      server << "<td scope='col'><input type='radio' name='paintcm' id='paintcm' value='0' "; if (paint_color_display_mode == 1) {
        server << "checked";
      } server << ">NORMAL </td>  ";
      server << "<td scope='col'><input type='radio' name='paintcm' id='paintcm'  value='1' "; if (paint_color_display_mode == 0) {
        server << "checked";
      } server << ">ADVANCED</td>";
      server << "<td><input type='submit' value='SAVE' /></td> ";
      server << "</tr>  ";
      server << "</table>";
      server << "</form>";
    } else if (mode == 8) {
      server << "<form id='sttext' name='sttext' action=''  method='post'>";
      server << "<table width='50%' border='0'>";
      server << "<tr>";
      server << "<td scope='col'> <label for='sts'>TEXT [MAX. 60 CHARS: a-z A-Z 0-9 ( ) [ ] . , + - ! # = : _ ? / ^ ; < > |  @  ß]</label></td>";
      server << "<td>";
      server << "</td> ";
      server << "<td scope='col' >";
      server << "<input name='sttext' type='text' id='sttext' value='";
      for (int i = 0; i < st_char_count; i++) {
        if (check_char(st_chars[i]) == 1) {
          server << st_chars[i];
        }
      }
      server << "' size='20'><br>";
      server << "</td>  ";
      server << "<td colspan='2'><input type='submit' value='SAVE AND CONVERT TEXT TO TABLE' /></td>";
      server << "</tr>";
      server << "</table> ";
      server << "</form>";
      server << " <form id='stcm' namestcmopt' action='' method='post'>";
      server << "<table width='50%' border='0'>";
      server << "<tr>";
      server << "<td><label for='stcm'>COLOR MODE</label> </td>";
      server << "<td scope='col'><input type='radio' name='stcm' id='stcm' value='0' "; if (st_color_mode == 0) {
        server << "checked";
      } server << ">RAINBOW</td>  ";
      server << "<td scope='col'><input type='radio' name='stcm' id='stcm'  value='1' "; if (st_color_mode == 1) {
        server << "checked";
      } server << ">STATIC COLOR</td>";
      server << "<td scope='col'><input type='radio' name='stcm' id='stcm'  value='2' "; if (st_color_mode == 2) {
        server << "checked";
      } server << ">RANDOM</td>";
      server << "<td><input type='submit' value='SAVE' /></td> ";
      server << "</tr>  ";
      server << "</table>";
      server << "</form>";
      server << "<form id='stspeed' name='stspeed' action=''  method='post'>";
      server << "<table width='50%' border='0'>";
      server << "<tr>";
      server << "<td scope='col'> <label for='sts'>SPEED</label></td>";
      server << "<td>";
      server << "    SPEED : <br>";
      server << "</td> ";
      server << "<td scope='col' >";
      server << "<input name='sts' type='number' id='sts' max='1000' min='0' step='1' value='"; server << st_speed; server << "' size='20'><br>";
      server << "</td>  ";
      server << "<td colspan='2'><input type='submit' value='SAVE' /></td>";
      server << "</tr>";
      server << "</table> ";
      server << "</form>";
      if (st_color_mode == 1) {
        server << "<form id='cch' name='cch' action='' method='post'>";
        server << "<table width='50%' border='0'>";
        server << "<tr>";
        server << "<td><label for='stfc'COLOR</label> </td>";
        server << "<td scope='col'><input type='radio' name='stfc' id='stfc' value='0' "; if (st_fix_color == 0) {
          server << "checked";
        } server << ">RED </td>  ";
        server << "<td scope='col'><input type='radio' name='stfc' id='stfc'  value='1' "; if (st_fix_color == 1) {
          server << "checked";
        } server << ">GREEN</td>";
        server << "<td scope='col'><input type='radio' name='stfc' id='stfc'  value='2' "; if (st_fix_color == 2) {
          server << "checked";
        } server << ">BLUE</td>";
        server << "<td scope='col'><input type='radio' name='stfc' id='stfc'  value='3' "; if (st_fix_color == 3) {
          server << "checked";
        } server << ">CYAN</td>";
        server << "<td scope='col'><input type='radio' name='stfc' id='stfc'  value='4' "; if (st_fix_color == 4) {
          server << "checked";
        } server << ">PINK</td>";
        server << "<td scope='col'><input type='radio' name='stfc' id='stfc'  value='5' "; if (st_fix_color == 5) {
          server << "checked";
        } server << ">YELLOW</td>";
        server << "<td scope='col'><input type='radio' name='stfc' id='stfc'  value='6' "; if (st_fix_color == 6) {
          server << "checked";
        } server << ">PSEUDO WHITE</td>";
        server << "<td><input type='submit' value='SAVE' /></td> ";
        server << "</tr>  ";
        server << "</table>";
        server << "</form>";
        server << "<form id='stb' name='stb' action=''  method='post'>";
        server << "<table width='50%' border='0'>";
        server << "<tr>";
        server << "<td scope='col'> <label for='stb'>COLOR BRIGHTNESS</label></td>";
        server << "<td>";
        server << "</td> ";
        server << "<td scope='col' >";
        server << "<input name='stb' type='number' id='stb' max='255' min='0' step='1' value='"; server << st_bright; server << "' size='20'><br>";
        server << "</td>  ";
        server << "<td colspan='2'><input type='submit' value='SAVE' /></td>";
        server << "</tr>";
        server << "</table> ";
        server << "</form>";
      } else if (st_color_mode == 0) {
        server << "<form id='strs' name='strs' action=''  method='post'>";
        server << "<table width='50%' border='0'>";
        server << "<tr>";
        server << "<td scope='col'> <label for='strs'>RAINBOW CYCLE SPEED</label></td>";
        server << "<td>";
        server << "    SPEED : <br>";
        server << "</td> ";
        server << "<td scope='col' >";
        server << "<input name='strs' type='number' id='strs' max='50' min='0' step='1' value='"; server << st_rain_speed; server << "' size='20'><br>";
        server << "</td>  ";
        server << "<td colspan='2'><input type='submit' value='SAVE' /></td>";
        server << "</tr>";
        server << "</table> ";
        server << "</form>";
      }
    } else if (mode == 2) {
      server << " <form id='opt' name='opt' action='' method='post'>";
      server << "<table width='50%' border='0'>";
      server << "<tr>";
      server << "<td><label for='rmode'>RAINBOW TYPE</label> </td>";
      server << "<td scope='col'><input type='radio' name='rmode' id='rmode' value='0' "; if (rainbowmode == 0) {
        server << "checked";
      } server << ">THEATRE</td>  ";
      server << "<td scope='col'><input type='radio' name='rmode' id='rmode'  value='1' "; if (rainbowmode == 1) {
        server << "checked";
      } server << ">CYCLE</td>";
      server << "<td scope='col'><input type='radio' name='rmode' id='rmode'  value='2' "; if (rainbowmode == 2) {
        server << "checked";
      } server << ">COMPLETE</td>";
      server << "<td scope='col'><input type='radio' name='rmode' id='rmode'  value='3' "; if (rainbowmode == 3) {
        server << "checked";
      } server << ">STACCATO</td>";
      server << "<td><input type='submit' value='SAVE' /></td> ";
      server << "</tr>  ";
      server << "</table>";
      server << "</form>";
      server << "<form id='speed' name='speed' action=''  method='post'>";
      server << "<table width='50%' border='0'>";
      server << "<tr>";
      server << "<td scope='col'> <label for='rsp'>RAINBOW SPEED</label></td>";
      server << "<td>";
      server << "    SPEED : <br>";
      server << "</td> ";
      server << "<td scope='col' >";
      server << "<input name='rsp' type='number' id='rsp' max='100000' min='0' step='1' value='"; server << rainbowspeed; server << "' size='5'><br>";
      server << "</td>  ";
      server << "<td colspan='2'><input type='submit' value='SAVE' /></td>";
      server << "</tr>";
      server << "</table> ";
      server << "</form>";
    } else if (mode == 3) {
      server << " <form id='opt' name='opt' action='' method='post'>";
      server << "<table width='50%' border='0'>";
      server << "<tr>";
      server << "<td><label for='ranmode'>RANDOM TYPE</label> </td>";
      server << "<td scope='col'><input type='radio' name='ranmode' id='ranmode' value='0' "; if (randommode == 0) {
        server << "checked";
      } server << ">ROW BY ROW</td>  ";
      server << "<td scope='col'><input type='radio' name='ranmode' id='ranmode'  value='1' "; if (randommode == 1) {
        server << "checked";
      } server << ">DIRECT</td>";
      server << "<td scope='col'><input type='radio' name='ranmode' id='ranmode'  value='2' "; if (randommode == 2) {
        server << "checked";
      } server << ">COMPLETE</td>";
      server << "<td><input type='submit' value='SAVE' /></td> ";
      server << "</tr>  ";
      server << "</table>";
      server << "</form>";
      server << "<form id='opt' name='opt' action='' method='post'>";
      server << "<table width='50%' border='0'>";
      server << "<tr>";
      server << "<td><label for='ranmode'>PIXEL APPEAR</label> </td>";
      server << "<td scope='col'><input type='radio' name='ranefmode' id='ranefmode' value='0' "; if (randomefmode == 0) {
        server << "checked";
      } server << ">SHIFTING</td>  ";
      server << "<td scope='col'><input type='radio' name='ranefmode' id='ranefmode'  value='1' "; if (randomefmode == 1) {
        server << "checked";
      } server << ">RANDOM</td>";
      server << "</table> ";
      server << "</form>";
      server << "<td><input type='submit' value='SAVE' /></td> ";
      server << "</tr>  ";
      server << "</table>";
      server << "</form>";
      server << "<form id='speed' name='speed' action=''  method='post'>";
      server << "<table width='50%' border='0'>";
      server << "<tr>";
      server << "<td scope='col'> <label for='ransp'>RANDOM SPEED</label></td>";
      server << "<td>";
      server << "    SPEED : <br>";
      server << "</td> ";
      server << "<td scope='col' >";
      server << "<input name='ransp' type='number' id='ransp' max='100000' min='0' step='1' value='"; server << randomspeed; server << "' size='5'><br>";
      server << "</td>  ";
      server << "<td colspan='2'><input type='submit' value='SAVE' /></td>";
      server << "</tr>";
      server << "</table> ";
      server << "</form>";
    } else if (mode == 6) {
      server << "<form id='clockcolor' name='clockcolor' action='' method='post'>";
      server << "<table width='50%' border='0'>";
      server << "<tr>";
      server << "<td><label for='fanstate'>CLOCK COLOR MODE</label> </td>";
      server << "<td scope='col'><input type='radio' name='clockcolor' id='clockcolor' value='0' "; if (clockcolormode == 0) {
        server << "checked";
      } server << ">RAINBOW </td>  ";
      server << "<td scope='col'><input type='radio' name='clockcolor' id='clockcolor'  value='1' "; if (clockcolormode == 1) {
        server << "checked";
      } server << ">FIX</td>";
      server << "<td><input type='submit' value='SAVE' /></td> ";
      server << "</tr>  ";
      server << "</table>";
      server << "</form>";
      if (clockcolormode == 0) {
        server << "<form id='speed' name='clockspeed' action=''  method='post'>";
        server << "<table width='50%' border='0'>";
        server << "<tr>";
        server << "<td scope='col'> <label for='paddle1size'>COLOR FADING SPEED</label></td>";
        server << "<td scope='col' >";
        server << "<input name='clockspeed' type='number' id='clockspeed' max='900' min='0' step='1' value='"; server << clock_color_speed; server << "' size='5'><br>";
        server << "</td>  ";
        server << "<td colspan='2'><input type='submit' value='SAVE' /></td>";
        server << "</tr>";
        server << "</table> ";
        server << "</form>";
      } else if (clockcolormode == 1) {
        server << "<form id='cch' name='cch' action='' method='post'>";
        server << "<table width='50%' border='0'>";
        server << "<tr>";
        server << "<td><label for='cch'HOUR COLOR</label> </td>";
        server << "<td scope='col'><input type='radio' name='cch' id='cch' value='0' "; if (clock_fix_color_h == 0) {
          server << "checked";
        } server << ">RED </td>  ";
        server << "<td scope='col'><input type='radio' name='cch' id='cch'  value='1' "; if (clock_fix_color_h == 1) {
          server << "checked";
        } server << ">GREEN</td>";
        server << "<td scope='col'><input type='radio' name='cch' id='cch'  value='2' "; if (clock_fix_color_h == 2) {
          server << "checked";
        } server << ">BLUE</td>";
        server << " <td scope='col'><input type='radio' name='cch' id='cch'  value='3' "; if (clock_fix_color_h == 3) {
          server << "checked";
        } server << ">CYAN</td>";
        server << "<td scope='col'><input type='radio' name='cch' id='cch'  value='4' "; if (clock_fix_color_h == 4) {
          server << "checked";
        } server << ">PINK</td>";
        server << "<td scope='col'><input type='radio' name='cch' id='cch'  value='5' "; if (clock_fix_color_h == 5) {
          server << "checked";
        } server << ">YELLOW</td>";
        server << "<td scope='col'><input type='radio' name='cch' id='cch'  value='6' "; if (clock_fix_color_h == 6) {
          server << "checked";
        } server << ">PSEUDO WHITE</td>";
        server << "<td><input type='submit' value='SAVE' /></td> ";
        server << " </tr>  ";
        server << "</table>";
        server << "</form>";
        server << "<form id='cch' name='cch' action='' method='post'>";
        server << "<table width='50%' border='0'>";
        server << "<tr>";
        server << "<td><label for='ccm'MINUTE COLOR</label> </td>";
        server << "<td scope='col'><input type='radio' name='ccm' id='ccm' value='0' "; if (clock_fix_color_m == 0) {
          server << "checked";
        } server << ">RED </td>  ";
        server << "<td scope='col'><input type='radio' name='ccm' id='ccm'  value='1' "; if (clock_fix_color_m == 1) {
          server << "checked";
        } server << ">GREEN</td>";
        server << "<td scope='col'><input type='radio' name='ccm' id='ccm'  value='2' "; if (clock_fix_color_m == 2) {
          server << "checked";
        } server << ">BLUE</td>";
        server << "<td scope='col'><input type='radio' name='ccm' id='ccm'  value='3' "; if (clock_fix_color_m == 3) {
          server << "checked";
        } server << ">CYAN</td>";
        server << "<td scope='col'><input type='radio' name='ccm' id='ccm'  value='4' "; if (clock_fix_color_m == 4) {
          server << "checked";
        } server << ">PINK</td>";
        server << "<td scope='col'><input type='radio' name='ccm' id='ccm'  value='5' "; if (clock_fix_color_m == 5) {
          server << "checked";
        } server << ">YELLOW</td>";
        server << "<td scope='col'><input type='radio' name='ccm' id='ccm'  value='6' "; if (clock_fix_color_m == 6) {
          server << "checked";
        } server << ">PSEUDO WHITE</td>";
        server << "<td><input type='submit' value='SAVE' /></td> ";
        server << "</tr>  ";
        server << "</table>";
        server << "</form>";
        server << "<form id='speed' name='cb' action=''  method='post'>";
        server << "<table width='50%' border='0'>";
        server << "<tr>";
        server << "<td scope='col'> <label for='cb'>CLOLOR BRIGHTNESS</label></td>";
        server << "<td scope='col' >";
        server << "<input name='cb' type='number' id='cb' max='255' min='0' step='1' value='"; server << clock_bright; server << "' size='5'><br>";
        server << "</td>  ";
        server << "<td colspan='2'><input type='submit' value='SAVE' /></td>";
        server << "</tr>";
        server << "</table> ";
        server << "</form>";
      } else {
      }
    } else if (mode == 4) {
      server << "<form id='opt' name='opt' action='' method='post'>";
      server << "<table width='50%' border='0'>";
      server << "<tr>";
      server << "<td><label for='pongmode'>PONG MODE</label> </td>";
      server << "<td scope='col'><input type='radio' name='pongmode' id='pongmode' value='0' "; if (pongmode == 0) {
        server << "checked";
      } server << ">2 PLAYER MODE ( with NES Controller)</td>  ";
      //server<<"<td scope='col'><input type='radio' name='pongmode' id='pongmode' value='2' ";if(pongmode == 2){server <<"checked";}server<<">2 PLAYER MODE EXTREME ( with NES Controller)</td>  ";
      server << "<td scope='col'><input type='radio' name='pongmode' id='pongmode'  value='1' "; if (pongmode == 1) {
        server << "checked";
      } server << ">AUTO PONG</td>";
      server << "<td><input type='submit' value='SAVE' /></td> ";
      server << "</tr>  ";
      server << "</table>";
      server << "</form>";
      if (pongmode == 0) {
        server << "<form id='opt' name='opt' action='' method='post'>";
        server << "<table width='50%' border='0'>";
        server << "<tr>";
        server << "<td><label for='pongmode'>CHEATMODE PLAYER 1</label> </td>";
        server << "<td scope='col'><input type='radio' name='chenp1' id='chenp1' value='0' "; if (chenp1 == 0) {
          server << "checked";
        } server << ">DISABLE </td>  ";
        server << "<td scope='col'><input type='radio' name='chenp1' id='chenp1'  value='1' "; if (chenp1 == 1) {
          server << "checked";
        } server << ">ENABLE</td>";
        server << "<td><input type='submit' value='SAVE' /></td> ";
        server << "</tr>  ";
        server << "</table>";
        server << "</form>";
        server << "<form id='opt' name='opt' action='' method='post'>";
        server << "<table width='50%' border='0'>";
        server << "<tr>";
        server << "<td><label for='pongmode'>CHEATMODE PLAYER 2</label> </td>";
        server << "<td scope='col'><input type='radio' name='chenp2' id='chenp2' value='0' "; if (chenp2 == 0) {
          server << "checked";
        } server << ">DISABLE </td>  ";
        server << "<td scope='col'><input type='radio' name='chenp2' id='chenp2'  value='1' "; if (chenp2 == 1) {
          server << "checked";
        } server << ">ENABLE</td>";
        server << "<td><input type='submit' value='SAVE' /></td> ";
        server << "</tr>  ";
        server << "</table>";
        server << "</form>";
        server << "<form id='speed' name='speed' action=''  method='post'>";
        server << "<table width='50%' border='0'>";
        server << "<tr>";
        server << "<td scope='col'> <label for='paddle1size'>PADDLE SIZE PLAYER 1</label></td>";
        server << "<td>";
        server << "    SPEED : <br>";
        server << "</td> ";
        server << "<td scope='col' >";
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
